lhr-solar/Controls-DashboardPCB/3d models/ToggleSwitch 3Pin.step

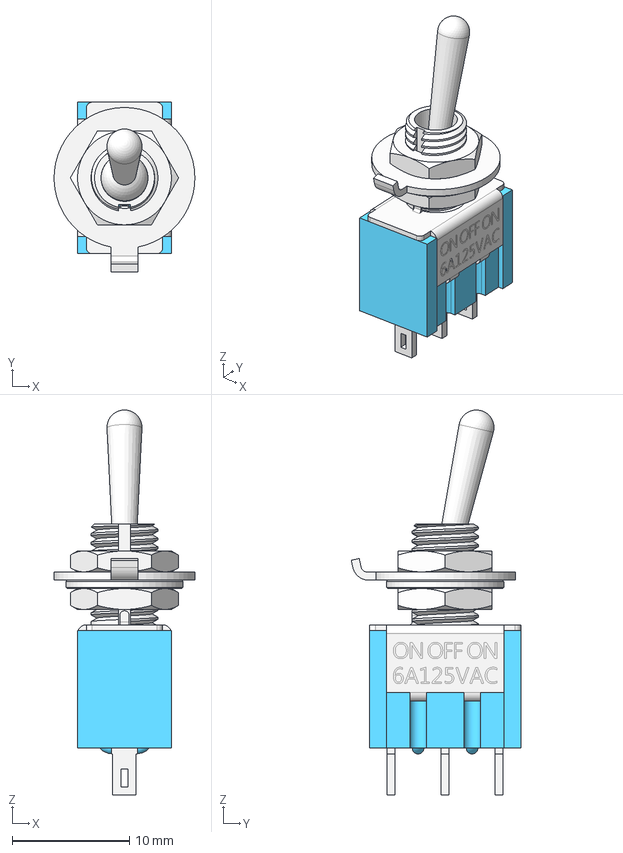
[picture p1: CAD file, 2025-03-05]
3d models/ToggleSwitch 3Pin.step
12.0 x 14.4 x 32.8 mm
Washer Anti Twist Protection
Nut M6x0.75mm
Nut M6x0.75mm clone
Sheetmatal Frame
Plastic Body
Thread
Batton Clone 1
PIN_1of3
PIN_2of3
PIN_3of3
Washer
