lhr-solar/Controls-DashboardPCB/hardware/ControlsLeader_PCB/Footprints/PRESENT Adj LDO/AP2205-50W5-7.STEP

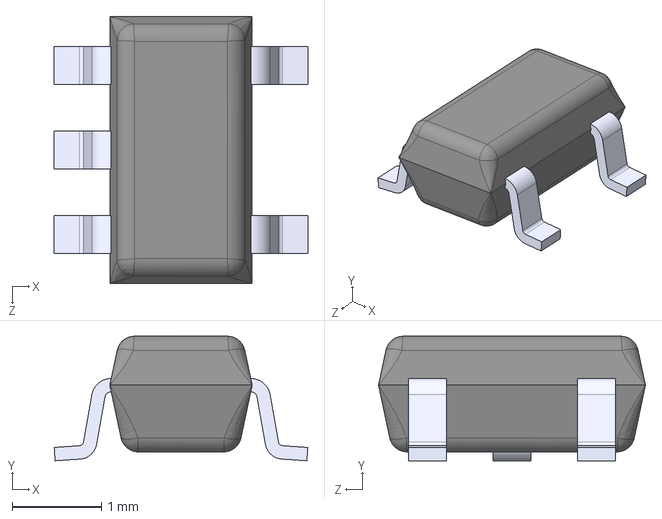
[picture p2: CAD file, 2026-01-14]
hardware/ControlsLeader_PCB/Footprints/PRESENT Adj LDO/AP2205-50W5-7.STEP
2.85 x 1.40 x 3.00 mm
