lhr-solar/Controls-DashboardPCB/3d models/2pin.stp

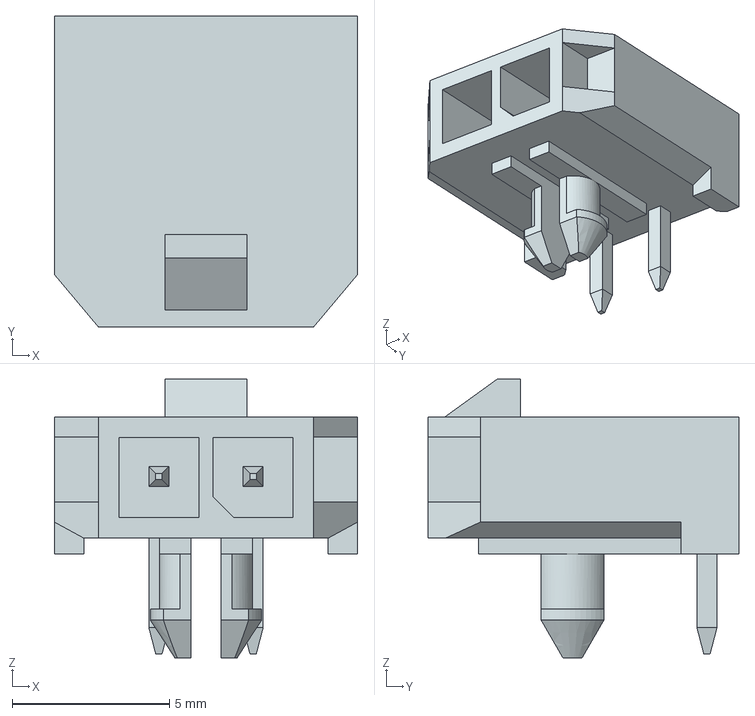
[picture p3: CAD file, 2025-03-05]
3d models/2pin.stp
9.65 x 9.90 x 8.87 mm
