lhr-solar/Controls-DashboardPCB/hardware/ControlsLeader_PCB/3d model/1x3_horizontal.stp

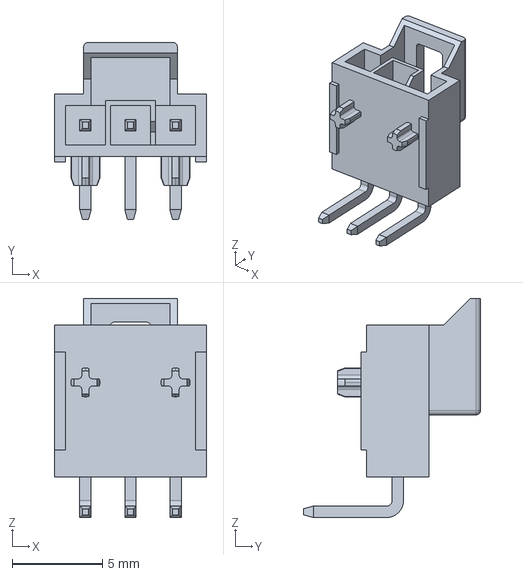
[picture p4: CAD file, 2026-01-15]
hardware/ControlsLeader_PCB/3d model/1x3_horizontal.stp
8.44 x 9.84 x 12.2 mm
