lhr-solar/Controls-DashboardPCB/3d models/2x2.stp

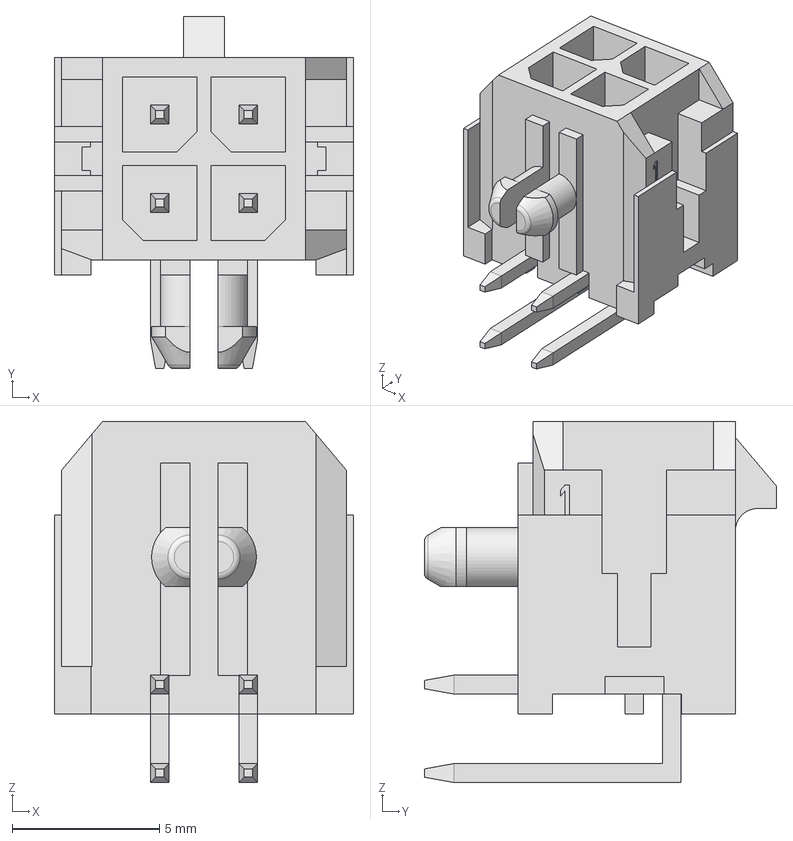
[picture p5: CAD file, 2025-03-05]
3d models/2x2.stp
10.2 x 11.9 x 12.2 mm
