lhr-solar/Controls-DashboardPCB/3d models/ToggleButt.stp

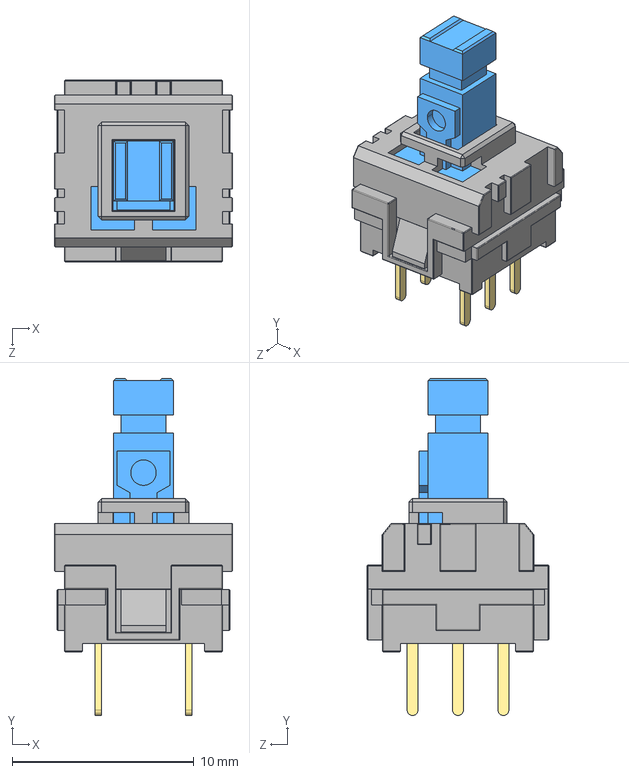
[picture p6: CAD file, 2025-03-05]
3d models/ToggleButt.stp
9.80 x 18.5 x 10.0 mm
