lhr-solar/Controls-DashboardPCB/hardware/ControlsLeader_PCB/3d model/1x06_horizontal.stp

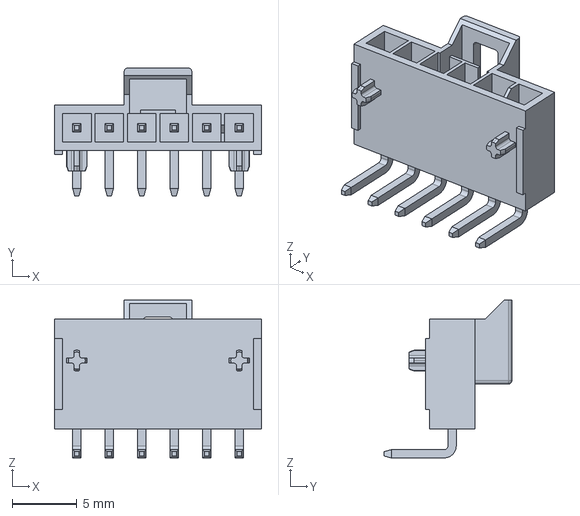
[picture p7: CAD file, 2026-01-15]
hardware/ControlsLeader_PCB/3d model/1x06_horizontal.stp
15.9 x 9.84 x 12.2 mm
