lhr-solar/Controls-DashboardPCB/3d models/rotary.stp

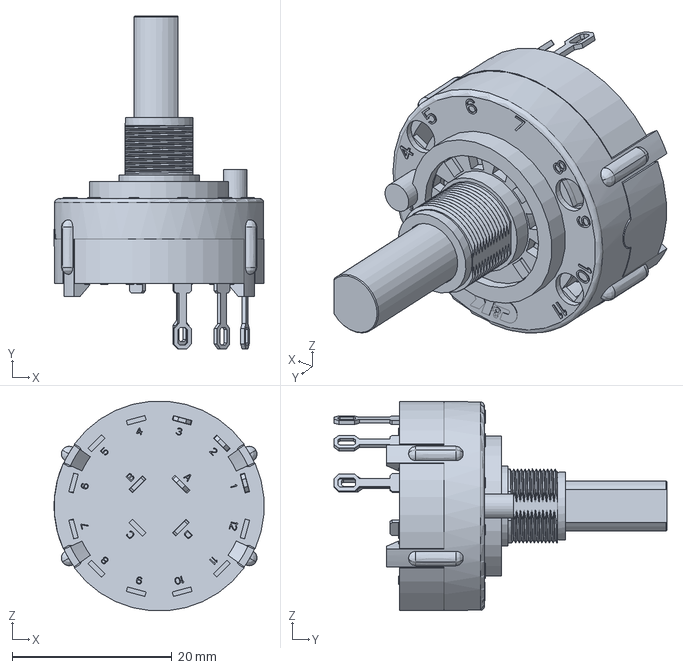
[picture p8: CAD file, 2025-03-05]
3d models/rotary.stp
26.3 x 41.7 x 26.2 mm
