lhr-solar/Controls-DashboardPCB/hardware/ControlsLeader_PCB/3d model/IRLML2030TRPBF.stp

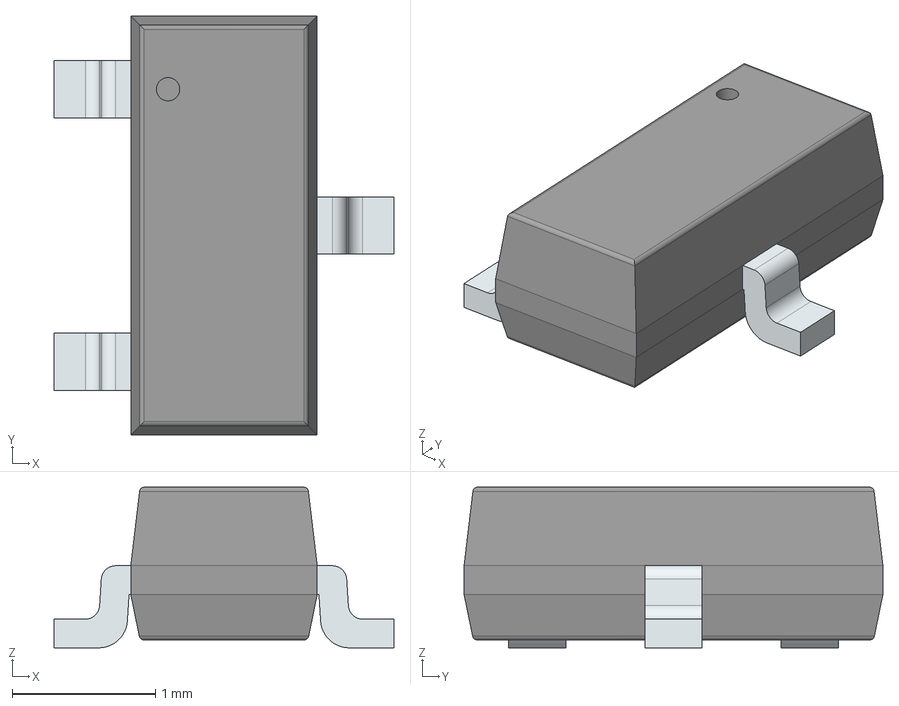
[picture p9: CAD file, 2026-01-15]
hardware/ControlsLeader_PCB/3d model/IRLML2030TRPBF.stp
2.37 x 2.92 x 1.12 mm
PinsArrayL
FilletPinR
