lhr-solar/Controls-DashboardPCB/3d models/Supplemental Battery Switch.STEP

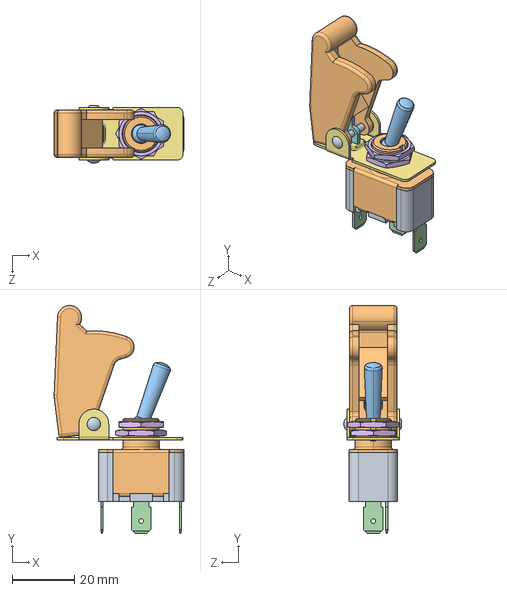
[picture p10: CAD file, 2025-03-05]
3d models/Supplemental Battery Switch.STEP
41.7 x 73.3 x 18.5 mm
22-ENC-1104.1 Supplemental Battery Toggle Switch
22-ENC-1104.2 Supplemental Battery Switch Safety Guard
