lhr-solar/Controls-DashboardPCB/hardware/ControlsLeader_PCB/3d model/2x6_horizontal.stp

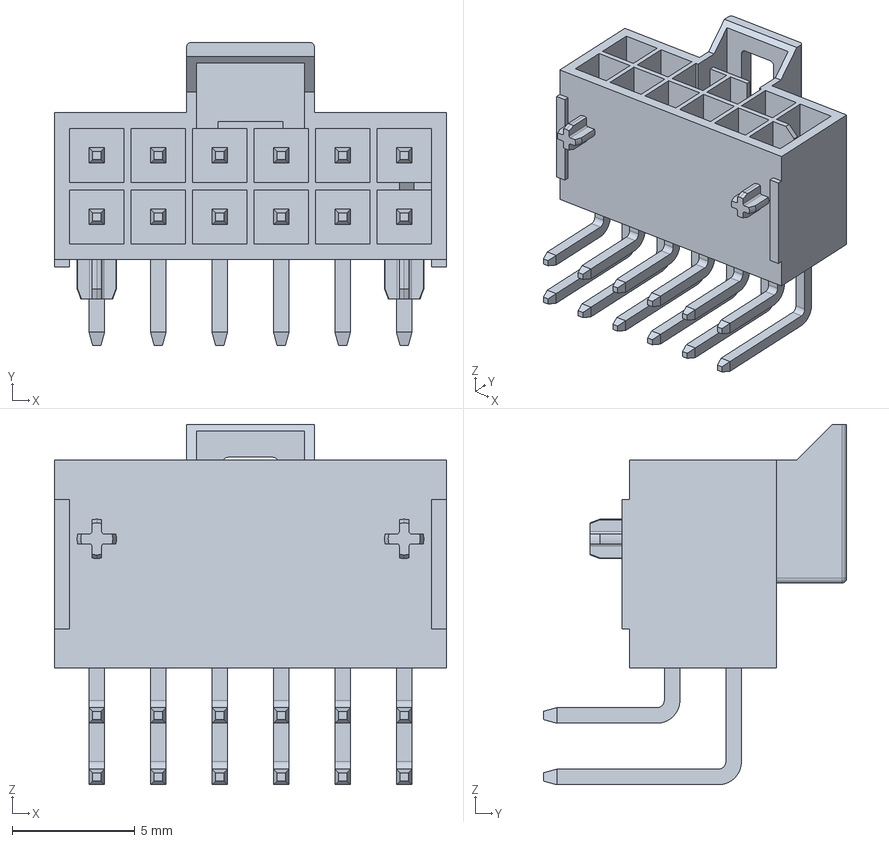
[picture p11: CAD file, 2026-01-15]
hardware/ControlsLeader_PCB/3d model/2x6_horizontal.stp
15.9 x 12.3 x 14.7 mm
