lhr-solar/Controls-DashboardPCB/3d models/2x6.stp

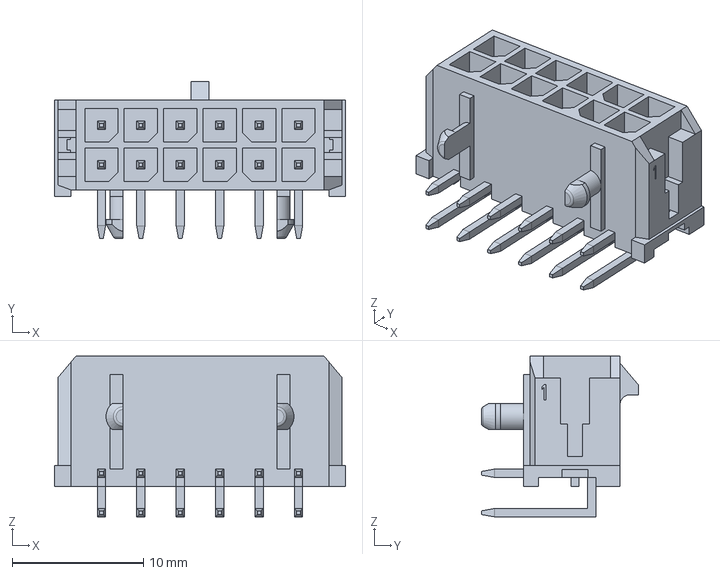
[picture p12: CAD file, 2025-03-05]
3d models/2x6.stp
22.1 x 11.9 x 12.2 mm
