lhr-solar/Controls-DashboardPCB/3d models/1x3.stp

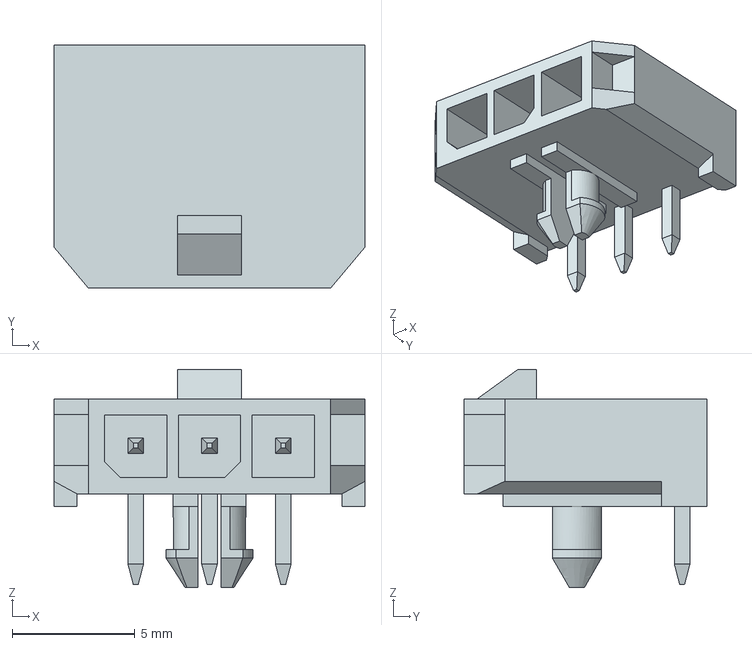
[picture p13: CAD file, 2025-03-05]
3d models/1x3.stp
12.7 x 9.90 x 8.87 mm
