lhr-solar/Controls-DashboardPCB/3d models/2x3.stp

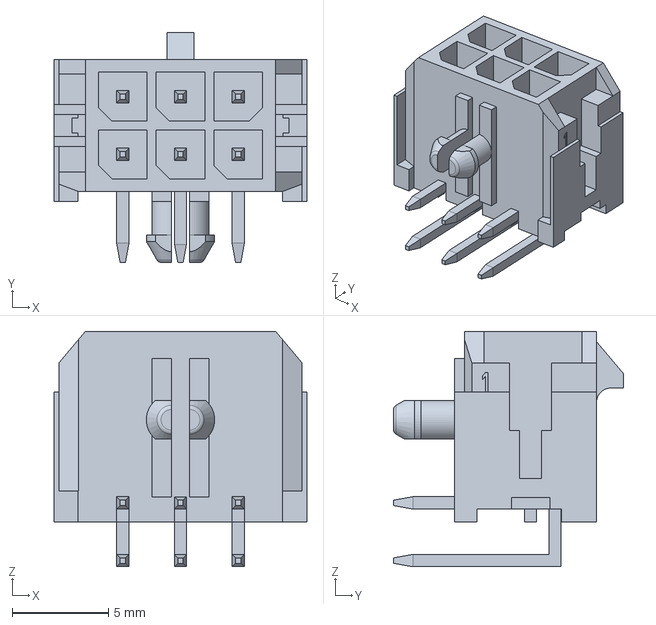
[picture p14: CAD file, 2025-03-05]
3d models/2x3.stp
13.2 x 11.9 x 12.2 mm
