lhr-solar/Controls-DashboardPCB/3d models/slide.STEP

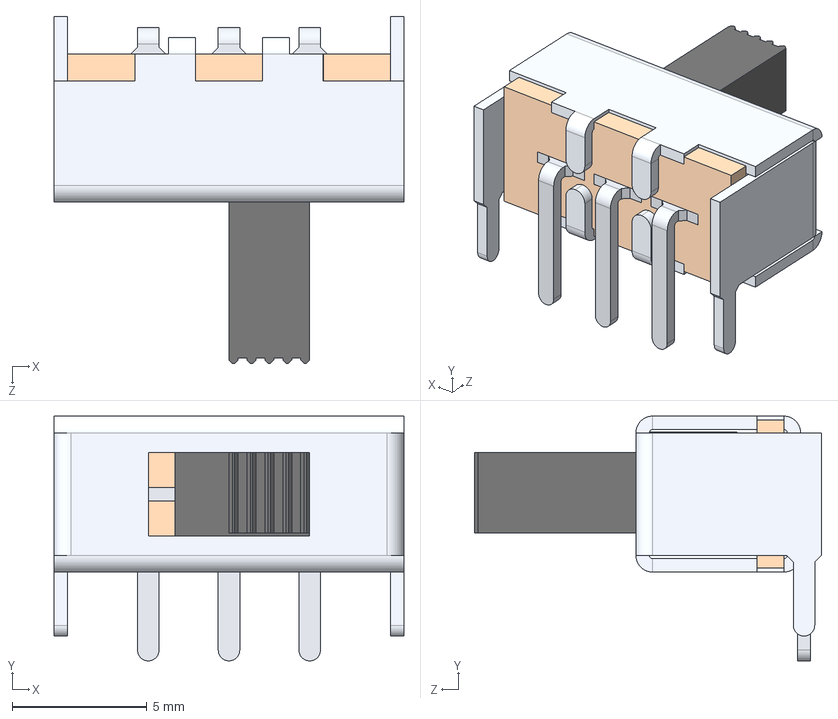
[picture p15: CAD file, 2025-03-05]
3d models/slide.STEP
13.0 x 9.10 x 12.9 mm
SLIDE SWITCH SS12F23 CAPA_Valor predeterminado
SLIDE SWITCH SS12F23 PCB_Valor predeterminado
SLIDE SWITCH SS12F23 CENTRAL_Valor predeterminado
SLIDE SWITCH SS12F23 LATERAL_Valor predeterminado x 2
SLIDE SWITCH SS12F23 ATUADOR_Valor predeterminado
SLIDE SWITCH SS12F23 Contato_Valor predeterminado
