lhr-solar/Controls-DashboardPCB/3d models/1x2vert.stp

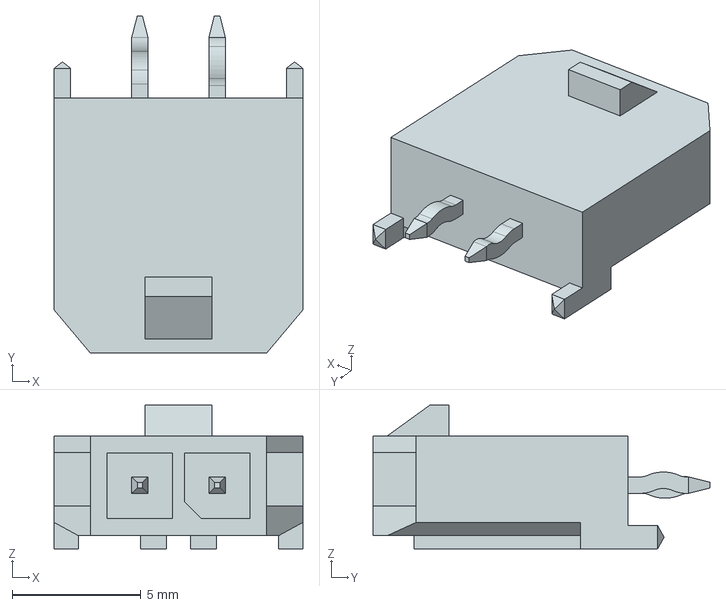
[picture p16: CAD file, 2025-03-05]
3d models/1x2vert.stp
9.65 x 13.1 x 5.57 mm
