lhr-solar/Controls-DashboardPCB/hardware/ControlsLeader_PCB/3d model/0805L100WR.stp

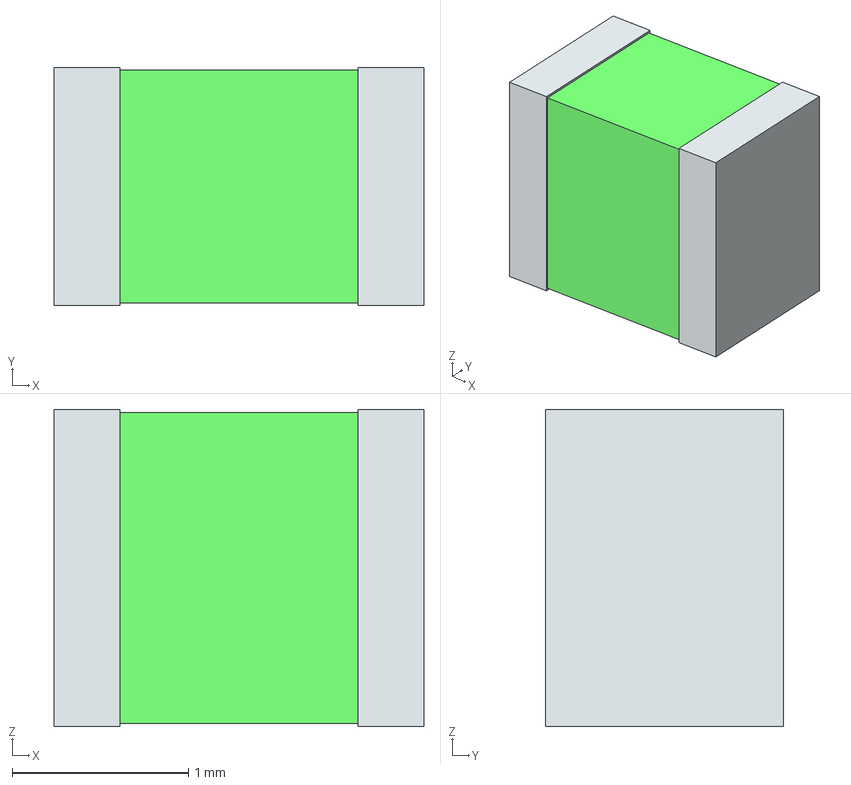
[picture p17: CAD file, 2026-01-15]
hardware/ControlsLeader_PCB/3d model/0805L100WR.stp
2.10 x 1.35 x 1.80 mm
term1
term2
