lhr-solar/Controls-DashboardPCB/(list of files, cad)

Other CAD files:
hardware/ControlsLeader_PCB/3d model/0603L025YR.stp
