lhr-solar/Controls-DashboardPCB/hardware/ControlsLeader_PCB/ControlsLeader_PCB.kicad_pcb

## KiCad design hardware/ControlsLeader_PCB/ControlsLeader_PCB.kicad_pcb (2026-01-15)

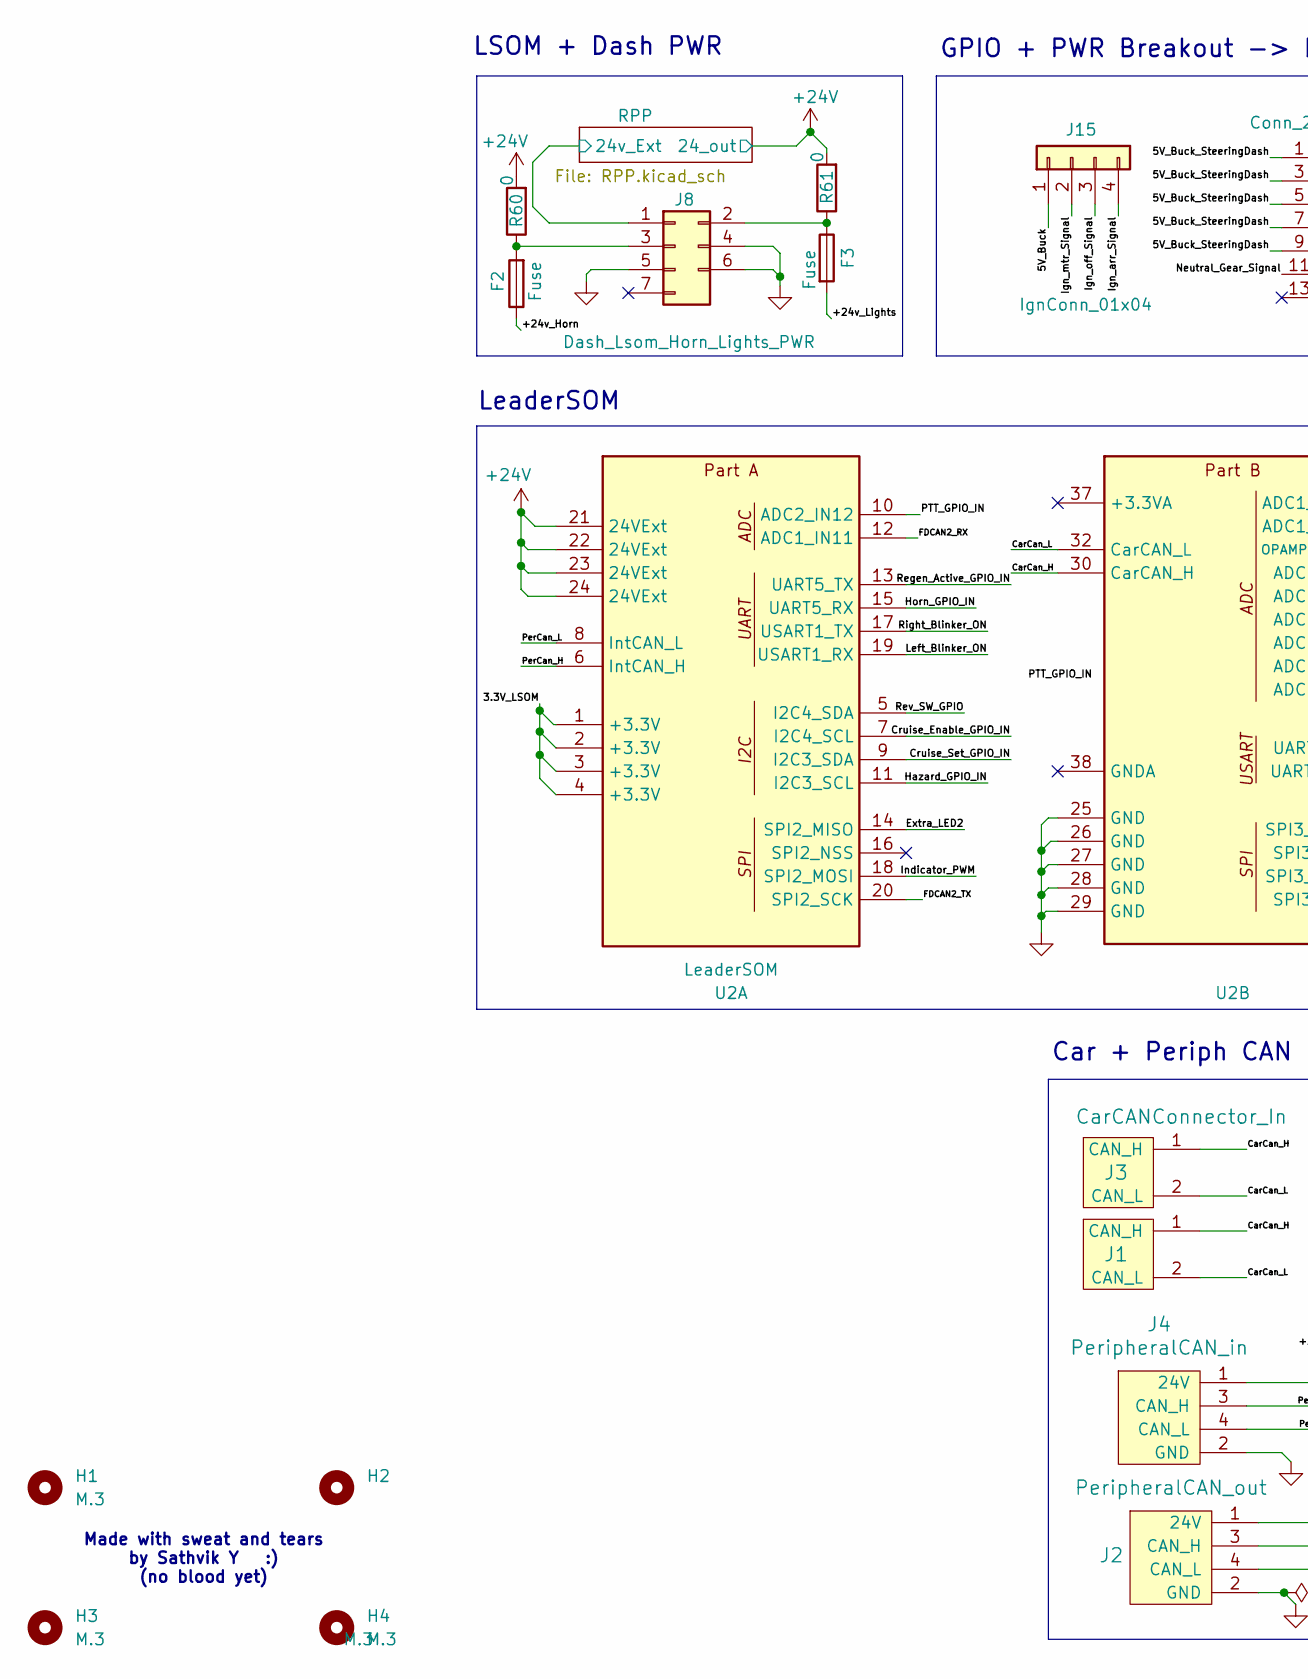
[picture p18: schematic ControlsLeader_PCB.kicad_sch, part in row 1, column 1]

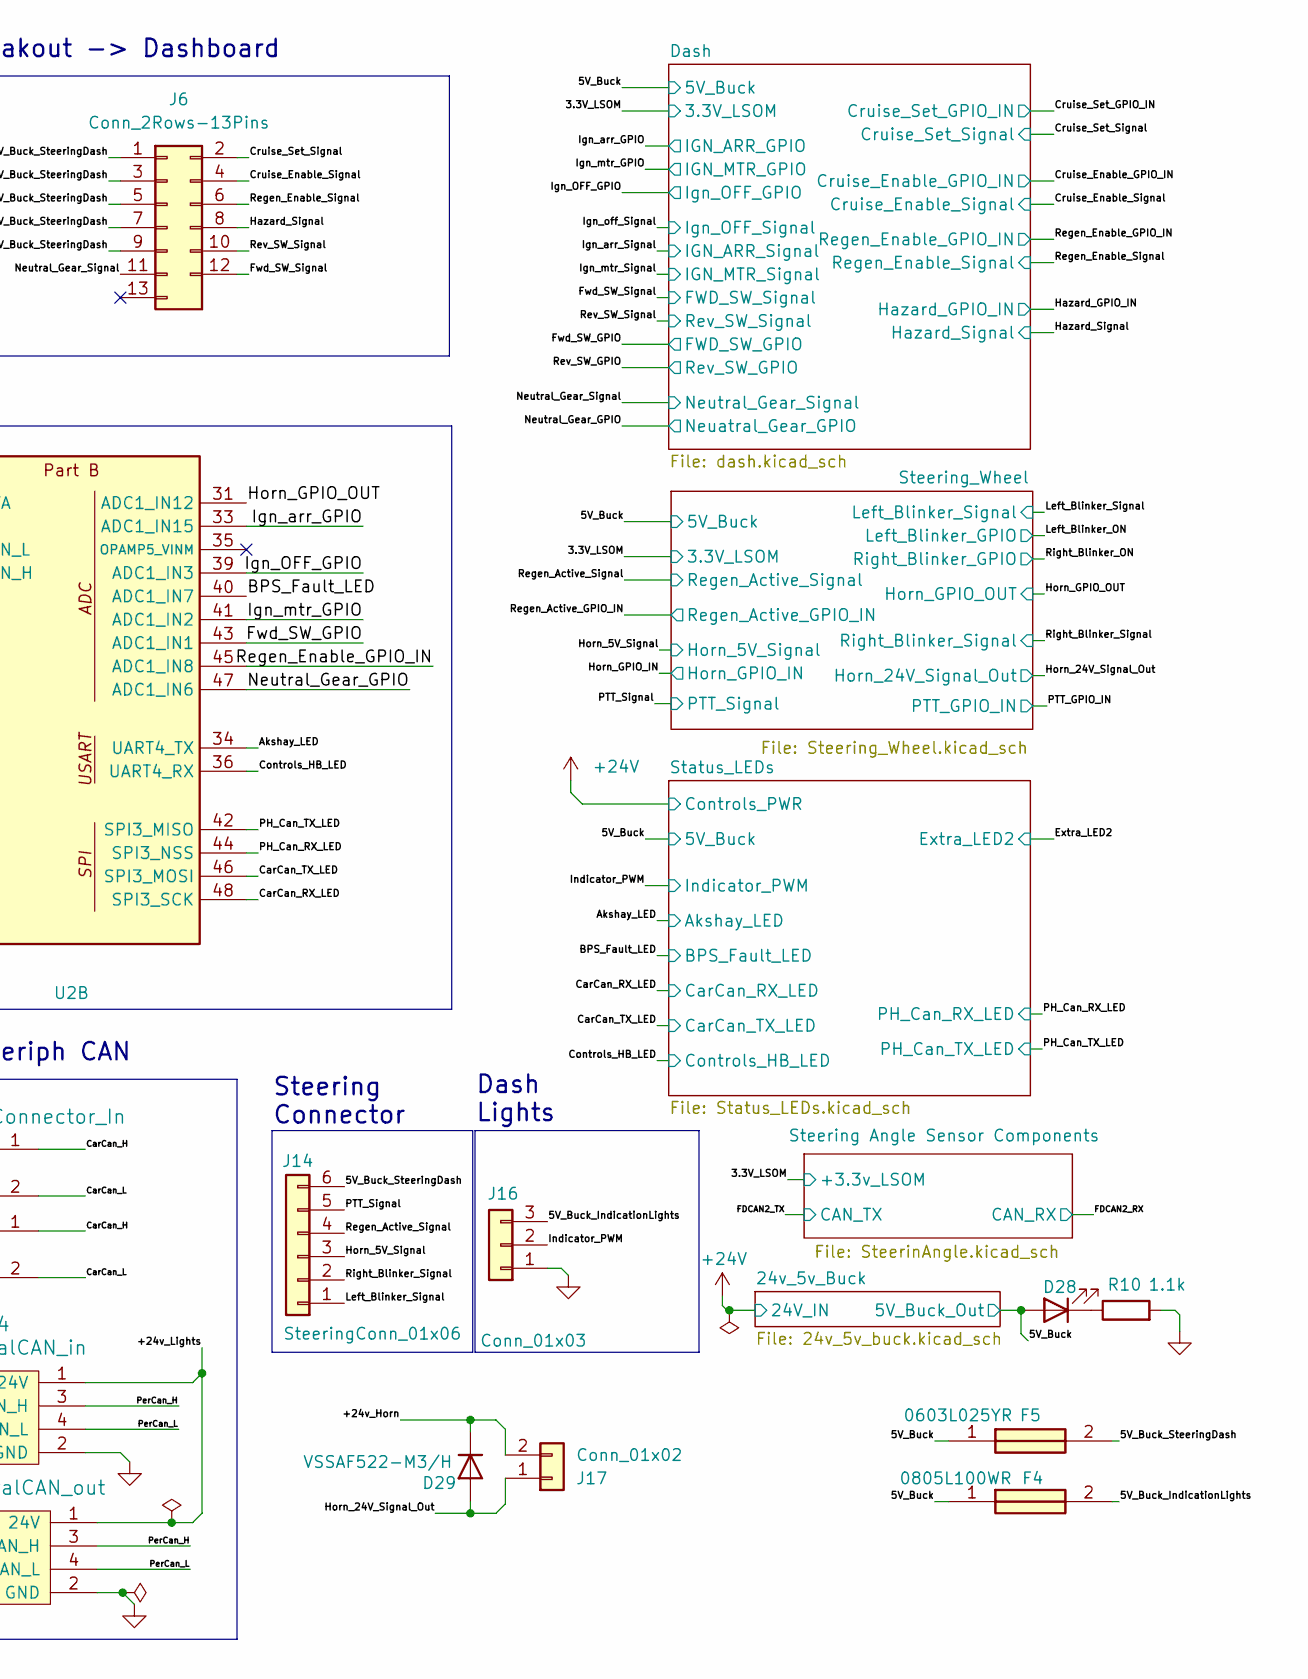
[picture p19: schematic ControlsLeader_PCB.kicad_sch, part in row 1, column 2]

Parts:
D28: Controls_Leader_Status_Red; LED_0603_1608Metric_Pad1.05x0.95mm_HandSolder
D29: VSSAF522-M3/H; D_SOD-123F
F2, F3: Fuse; Fuseholder_Blade_Mini_Keystone_3568
F4: 0805L100WR; FUSC2114X180N; Mouser Part Number 576-0805L100
F5: 0603L025YR; FUSC1608X75N; Mouser Part Number 576-0603L025YR
H1, H2, H3, H4: M.3; MountingHole_3.2mm_M3_Pad_TopBottom
J1: CarCANConnector_Out; Molex_Nano-Fit_105313-xx02_1x02_P2.50mm_Horizontal
J2: PeripheralCAN_out; Molex_Nano-Fit_105313-xx04_1x04_P2.50mm_Horizontal
J3: CarCANConnector_In; Molex_Nano-Fit_105313-xx02_1x02_P2.50mm_Horizontal
J4: PeripheralCAN_in; Molex_Nano-Fit_105313-xx04_1x04_P2.50mm_Horizontal
J6: Conn_2Rows-13Pins; Molex_Nano-Fit_105314-xx12_2x06_P2.50mm_Horizontal
J8: Dash_Lsom_Horn_Lights_PWR; Molex_Nano-Fit_105314-xx06_2x03_P2.50mm_Horizontal
J14: SteeringConn_01x06; Molex_Nano-Fit_105313-xx06_1x06_P2.50mm_Horizontal
J15: IgnConn_01x04; Molex_Nano-Fit_105313-xx04_1x04_P2.50mm_Horizontal
J16: Conn_01x03; Molex_Nano-Fit_105313-xx03_1x03_P2.50mm_Horizontal
J17: Conn_01x02; Molex_Nano-Fit_105313-xx02_1x02_P2.50mm_Horizontal
R10: 1.1k; R_0603_1608Metric_Pad0.98x0.95mm_HandSolder
R60, R61: 0; R_0603_1608Metric_Pad0.98x0.95mm_HandSolder
U2: LeaderSOM

Connections:
+24V: R60.2, R61.2, U2.21 (24VExt), U2.22 (24VExt), U2.23 (24VExt), U2.24 (24VExt); also elsewhere on the board
/3.3V_LSOM: U2.1 (+3.3V), U2.2 (+3.3V), U2.3 (+3.3V), U2.4 (+3.3V); also elsewhere on the board
/5V_Buck: D28.2 (A), F4.1, F5.1, J15.1; also elsewhere on the board
/5V_Buck_IndicationLights: F4.2, J16.3
/5V_Buck_SteeringDash: F5.2, J6.1, J6.3, J6.5, J6.7, J6.9, J14.6
/+24v_Horn: D29.1 (K), F2.1, J17.2
/+24v_Lights: F3.2, J2.1 (24V), J4.1 (24V)
/Akshay_LED: U2.34 (UART4_TX); also elsewhere on the board
/BPS_Fault_LED: U2.40 (ADC1_IN7); also elsewhere on the board
/CarCan_H: J1.1 (CAN_H), J3.1 (CAN_H), U2.30 (CarCAN_H)
/CarCan_L: J1.2 (CAN_L), J3.2 (CAN_L), U2.32 (CarCAN_L)
/CarCan_RX_LED: U2.48 (SPI3_SCK); also elsewhere on the board
/CarCan_TX_LED: U2.46 (SPI3_MOSI); also elsewhere on the board
/Controls_HB_LED: U2.36 (UART4_RX); also elsewhere on the board
/Cruise_Enable_GPIO_IN: U2.7 (I2C4_SCL); also elsewhere on the board
/Cruise_Enable_Signal: J6.4; also elsewhere on the board
/Cruise_Set_GPIO_IN: U2.9 (I2C3_SDA); also elsewhere on the board
/Cruise_Set_Signal: J6.2; also elsewhere on the board
/Extra_LED2: U2.14 (SPI2_MISO); also elsewhere on the board
/FDCAN2_RX: U2.12 (ADC1_IN11); also elsewhere on the board
/FDCAN2_TX: U2.20 (SPI2_SCK); also elsewhere on the board
/Fwd_SW_GPIO: U2.43 (ADC1_IN1); also elsewhere on the board
/Fwd_SW_Signal: J6.12; also elsewhere on the board
/Hazard_GPIO_IN: U2.11 (I2C3_SCL); also elsewhere on the board
/Hazard_Signal: J6.8; also elsewhere on the board
/Horn_5V_Signal: J14.3; also elsewhere on the board
/Horn_24V_Signal_Out: D29.2 (A), J17.1; also elsewhere on the board
/Horn_GPIO_IN: U2.15 (UART5_RX); also elsewhere on the board
/Horn_GPIO_OUT: U2.31 (ADC1_IN12); also elsewhere on the board
/Ign_OFF_GPIO: U2.39 (ADC1_IN3); also elsewhere on the board
/Ign_arr_GPIO: U2.33 (ADC1_IN15); also elsewhere on the board
/Ign_arr_Signal: J15.4; also elsewhere on the board
/Ign_mtr_GPIO: U2.41 (ADC1_IN2); also elsewhere on the board
/Ign_mtr_Signal: J15.2; also elsewhere on the board
/Ign_off_Signal: J15.3; also elsewhere on the board
/Indicator_PWM: J16.2, U2.18 (SPI2_MOSI)
/Left_Blinker_ON: U2.19 (USART1_RX); also elsewhere on the board
/Left_Blinker_Signal: J14.1; also elsewhere on the board
/Neutral_Gear_GPIO: U2.47 (ADC1_IN6); also elsewhere on the board
/Neutral_Gear_Signal: J6.11; also elsewhere on the board
/PH_Can_RX_LED: U2.44 (SPI3_NSS); also elsewhere on the board
/PH_Can_TX_LED: U2.42 (SPI3_MISO); also elsewhere on the board
/PTT_GPIO_IN: U2.10 (ADC2_IN12); also elsewhere on the board
/PTT_Signal: J14.5; also elsewhere on the board
/PerCan_H: J2.3 (CAN_H), J4.3 (CAN_H), U2.6 (IntCAN_H)
/PerCan_L: J2.4 (CAN_L), J4.4 (CAN_L), U2.8 (IntCAN_L)
/RPP/LV+: J8.1; also elsewhere on the board
/Regen_Active_GPIO_IN: U2.13 (UART5_TX); also elsewhere on the board
/Regen_Active_Signal: J14.4; also elsewhere on the board
/Regen_Enable_GPIO_IN: U2.45 (ADC1_IN8); also elsewhere on the board
/Regen_Enable_Signal: J6.6; also elsewhere on the board
/Rev_SW_GPIO: U2.5 (I2C4_SDA); also elsewhere on the board
/Rev_SW_Signal: J6.10; also elsewhere on the board
/Right_Blinker_ON: U2.17 (USART1_TX); also elsewhere on the board
/Right_Blinker_Signal: J14.2; also elsewhere on the board
GND: J2.2 (GND), J4.2 (GND), J8.4, J8.5, J8.6, J16.1, R10.2, U2.25 (GND), U2.26 (GND), U2.27 (GND), U2.28 (GND), U2.29 (GND); also elsewhere on the board
unnamed: D28.1 (K), R10.1
unnamed: F3.1, J8.2, R61.1
unnamed: F2.2, J8.3, R60.1

Notes on the sheet:
Car + Periph CAN
Dash Lights
GPIO + PWR Breakout -> Dashboard
Steering Connector
LSOM + Dash PWR
LeaderSOM
Made with sweat and tears by Sathvik Y :) (no blood yet)

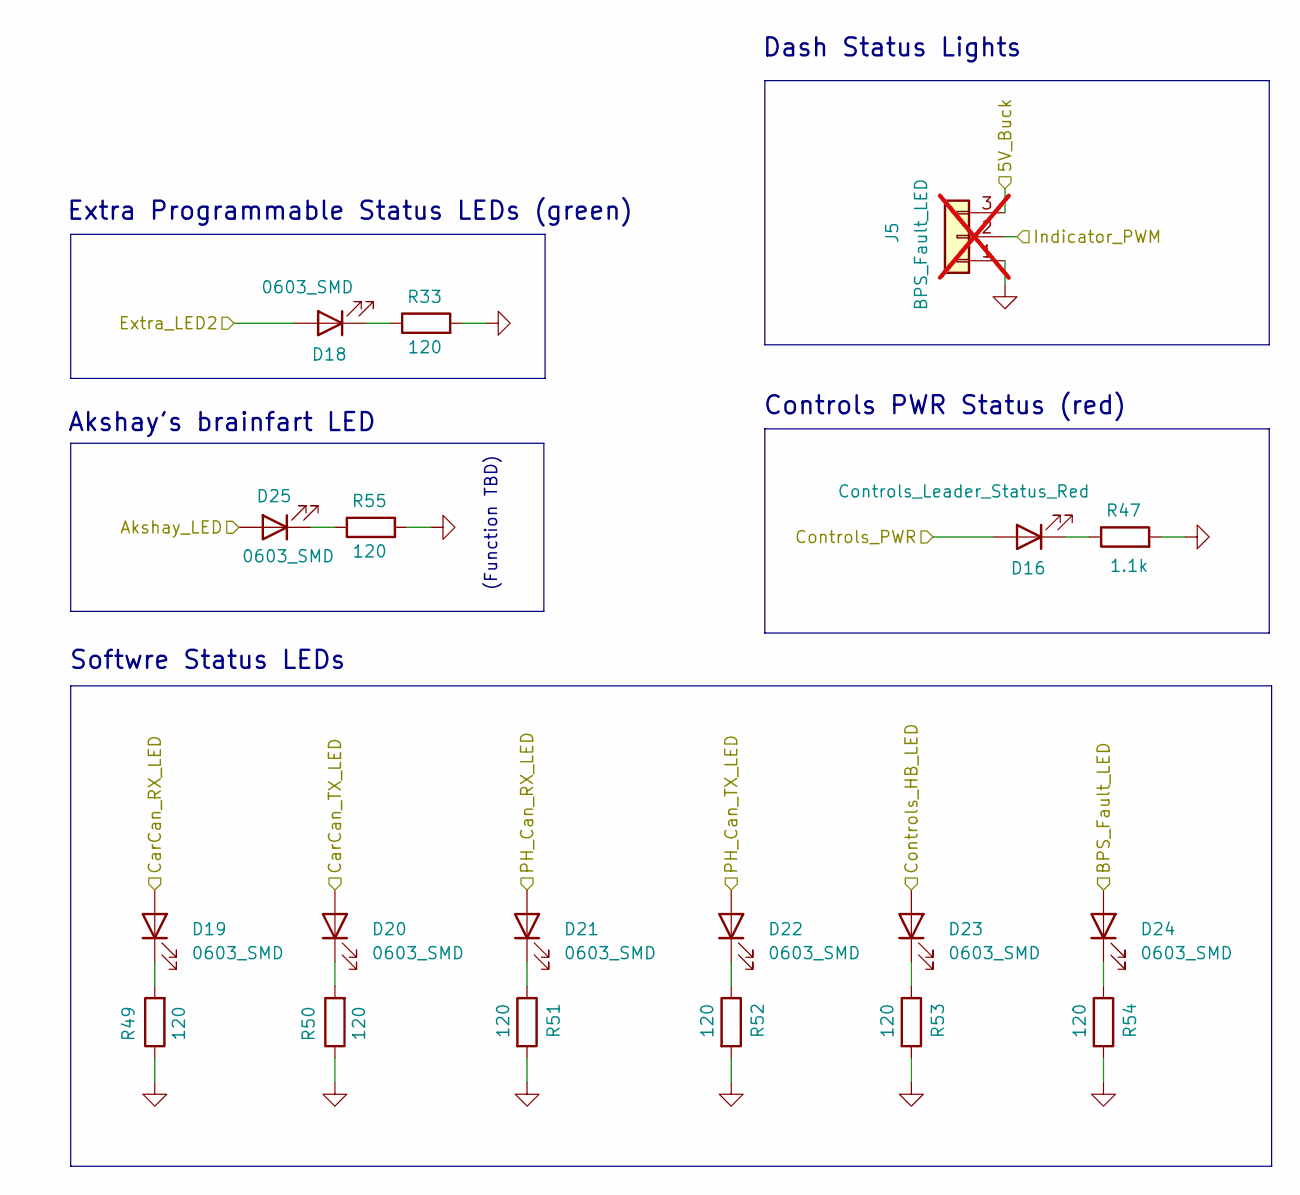
[picture p20: schematic Status_LEDs.kicad_sch]

Parts:
D16: Controls_Leader_Status_Red; LED_0603_1608Metric_Pad1.05x0.95mm_HandSolder
D18, D19, D20, D21, D22, D23, D24, D25: 0603_SMD; LED_0603_1608Metric_Pad1.05x0.95mm_HandSolder
J5: BPS_Fault_LED; Molex_Micro-Fit_3.0_43650-0300_1x03_P3.00mm_Horizontal; not fitted
R33, R49, R50, R51, R52, R53, R54, R55: 120; R_0603_1608Metric_Pad0.98x0.95mm_HandSolder
R47: 1.1k; R_0603_1608Metric_Pad0.98x0.95mm_HandSolder

Connections:
+24V: D16.2 (A); also elsewhere on the board
/Akshay_LED: D25.2 (A); also elsewhere on the board
/BPS_Fault_LED: D24.2 (A); also elsewhere on the board
/CarCan_RX_LED: D19.2 (A); also elsewhere on the board
/CarCan_TX_LED: D20.2 (A); also elsewhere on the board
/Controls_HB_LED: D23.2 (A); also elsewhere on the board
/Extra_LED2: D18.2 (A); also elsewhere on the board
/PH_Can_RX_LED: D21.2 (A); also elsewhere on the board
/PH_Can_TX_LED: D22.2 (A); also elsewhere on the board
GND: J5.1, R33.2, R47.2, R49.1, R50.1, R51.2, R52.2, R53.2, R54.2, R55.2; also elsewhere on the board
unnamed: D16.1 (K), R47.1
unnamed: D18.1 (K), R33.1
unnamed: D19.1 (K), R49.2
unnamed: D20.1 (K), R50.2
unnamed: D21.1 (K), R51.1
unnamed: D22.1 (K), R52.1
unnamed: D23.1 (K), R53.1
unnamed: D24.1 (K), R54.1
unnamed: D25.1 (K), R55.1

Notes on the sheet:
Akshay's brainfart LED
Extra Programmable Status LEDs (green)
Softwre Status LEDs
Controls PWR Status (red)
(Function TBD)
Dash Status Lights

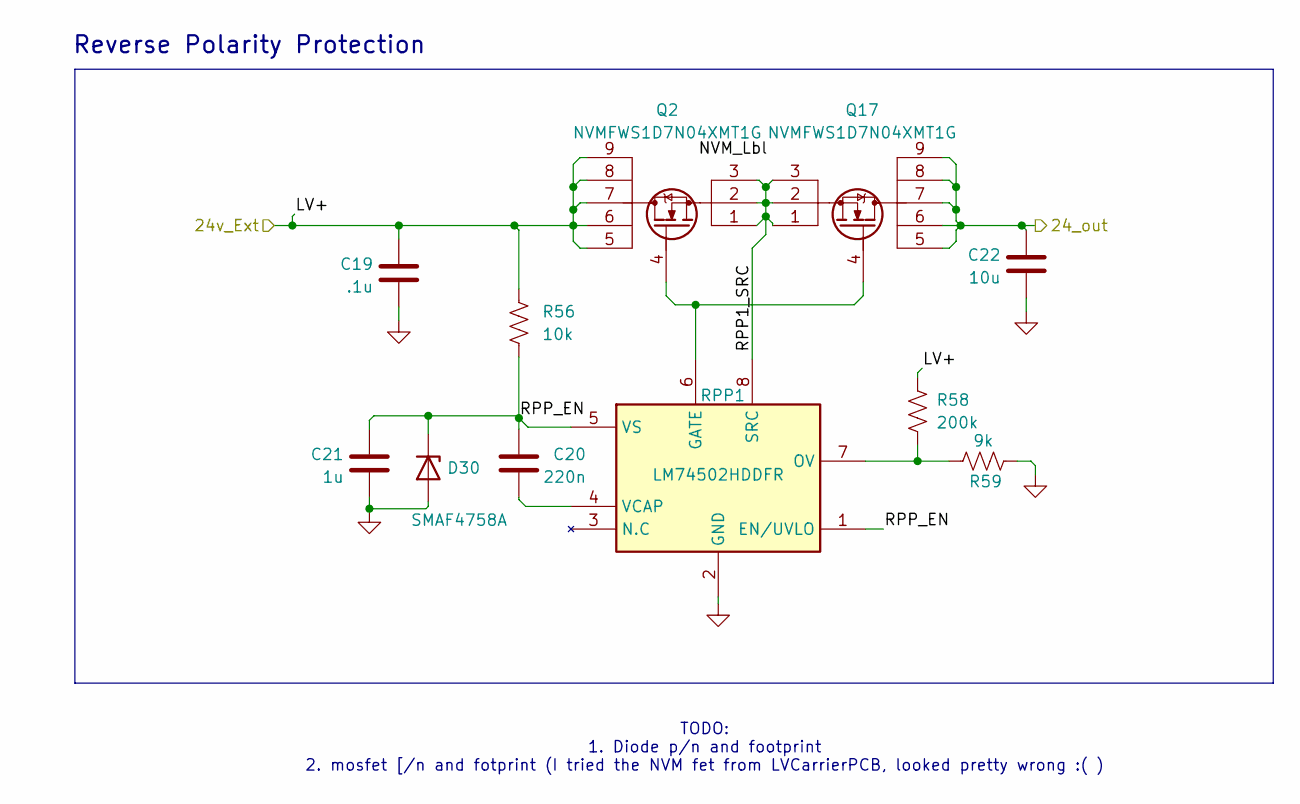
[picture p21: schematic RPP.kicad_sch]

Parts:
C19: .1u; C_0603_1608Metric_Pad1.08x0.95mm_HandSolder; Manufacturer_Part_Number 06035C223K4T4A
C20: 220n; C_0603_1608Metric_Pad1.08x0.95mm_HandSolder; Manufacturer_Part_Number 06035C223K4T4A
C21: 1u; C_0603_1608Metric_Pad1.08x0.95mm_HandSolder; Manufacturer_Part_Number 06035C223K4T4A
C22: 10u; C_0603_1608Metric_Pad1.08x0.95mm_HandSolder; Manufacturer_Part_Number 06035C223K4T4A
D30: SMAF4758A; SODFL5026X125N
Q2, Q17: NVMFWS1D7N04XMT1G; NVMFWS3D0P04M8LT1G
R56: 10k; R_0603_1608Metric_Pad0.98x0.95mm_HandSolder; Manufacturer_Part_Number CRCW060310K0FKEI
R58: 200k; R_0603_1608Metric_Pad0.98x0.95mm_HandSolder; Manufacturer_Part_Number CRCW060310K0FKEI
R59: 9k; R_0603_1608Metric_Pad0.98x0.95mm_HandSolder; Manufacturer_Part_Number CRCW060310K0FKEI
RPP1: LM74502HDDFR; SOT65P280X110-8N; Mouser Part Number 595-LM74502HDDFR

Connections:
+24V: C22.2, Q17.5, Q17.6, Q17.7, Q17.8, Q17.9; also elsewhere on the board
/RPP/LV+: C19.2, Q2.5, Q2.6, Q2.7, Q2.8, Q2.9, R56.1, R58.1; also elsewhere on the board
/RPP/RPP1_SRC: Q2.1, Q2.2, Q2.3, Q17.1, Q17.2, Q17.3, RPP1.8 (SRC)
/RPP/RPP_EN: C20.2, C21.2, D30.1 (K), R56.2, RPP1.1 (EN/UVLO), RPP1.5 (VS)
GND: C19.1, C21.1, C22.1, D30.2 (A), R59.2, RPP1.2 (GND); also elsewhere on the board
unnamed: Q2.4, Q17.4, RPP1.6 (GATE)
unnamed: R58.2, R59.1, RPP1.7 (OV)
unnamed: C20.1, RPP1.4 (VCAP)

Notes on the sheet:
TODO: 1. Diode p/n and footprint 2. mosfet [/n and fotprint (I tried the NVM fet from LVCarrierPCB, looked pretty wrong :( )
Reverse Polarity Protection

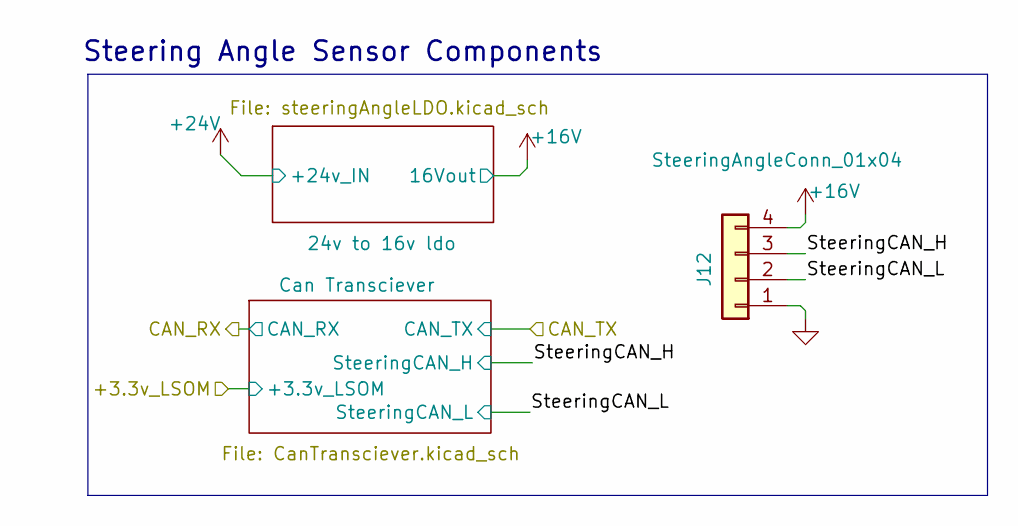
[picture p22: schematic SteerinAngle.kicad_sch]

Parts:
J12: SteeringAngleConn_01x04; Molex_Nano-Fit_105313-xx04_1x04_P2.50mm_Horizontal

Connections:
+16V: J12.4; also elsewhere on the board
/Steering Angle Sensor Components/SteeringCAN_H: J12.3; also elsewhere on the board
/Steering Angle Sensor Components/SteeringCAN_L: J12.2; also elsewhere on the board
GND: J12.1; also elsewhere on the board

Notes on the sheet:
Steering Angle Sensor Components

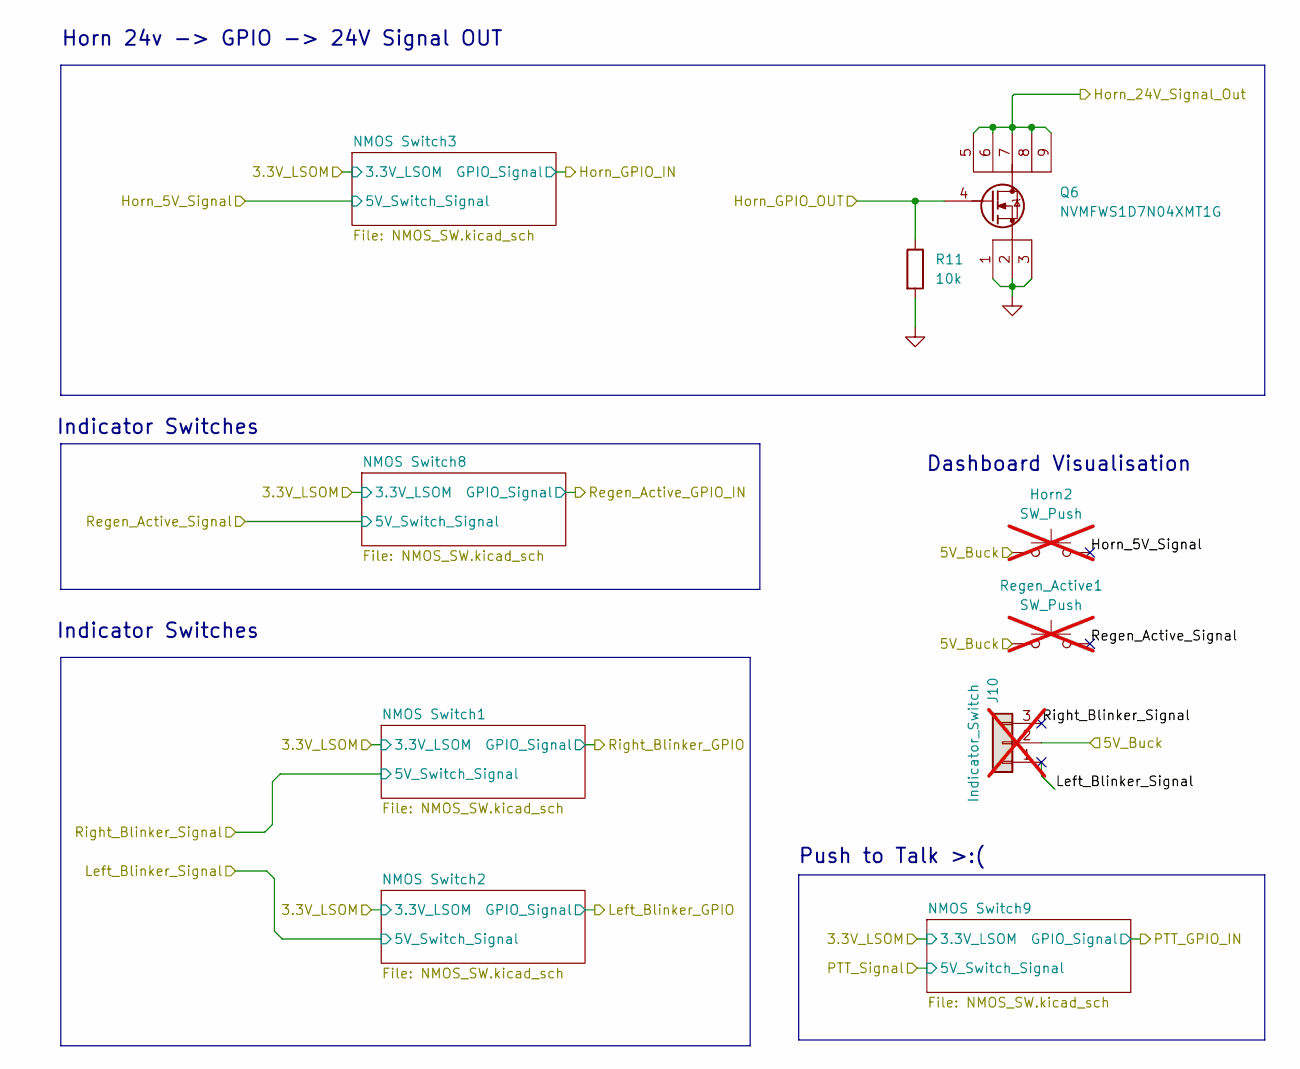
[picture p23: schematic Steering_Wheel.kicad_sch]

Parts:
Horn2: SW_Push; Molex_Nano-Fit_105313-xx02_1x02_P2.50mm_Horizontal; not fitted
J10: Indicator_Switch; Molex_Nano-Fit_105313-xx03_1x03_P2.50mm_Horizontal; not fitted
Q6: NVMFWS1D7N04XMT1G; NVMFWS3D0P04M8LT1G
R11: 10k; R_0603_1608Metric_Pad0.98x0.95mm_HandSolder
Regen_Active1: SW_Push; Molex_Nano-Fit_105313-xx02_1x02_P2.50mm_Horizontal; not fitted

Connections:
/Horn_24V_Signal_Out: Q6.5, Q6.6, Q6.7, Q6.8, Q6.9; also elsewhere on the board
/Horn_GPIO_OUT: Q6.4, R11.1; also elsewhere on the board
GND: Q6.1, Q6.2, Q6.3, R11.2; also elsewhere on the board
unnamed: Horn2.1, J10.2, Regen_Active1.1

Notes on the sheet:
Push to Talk >:(
Indicator Switches
Horn 24v -> GPIO -> 24V Signal OUT
Dashboard Visualisation

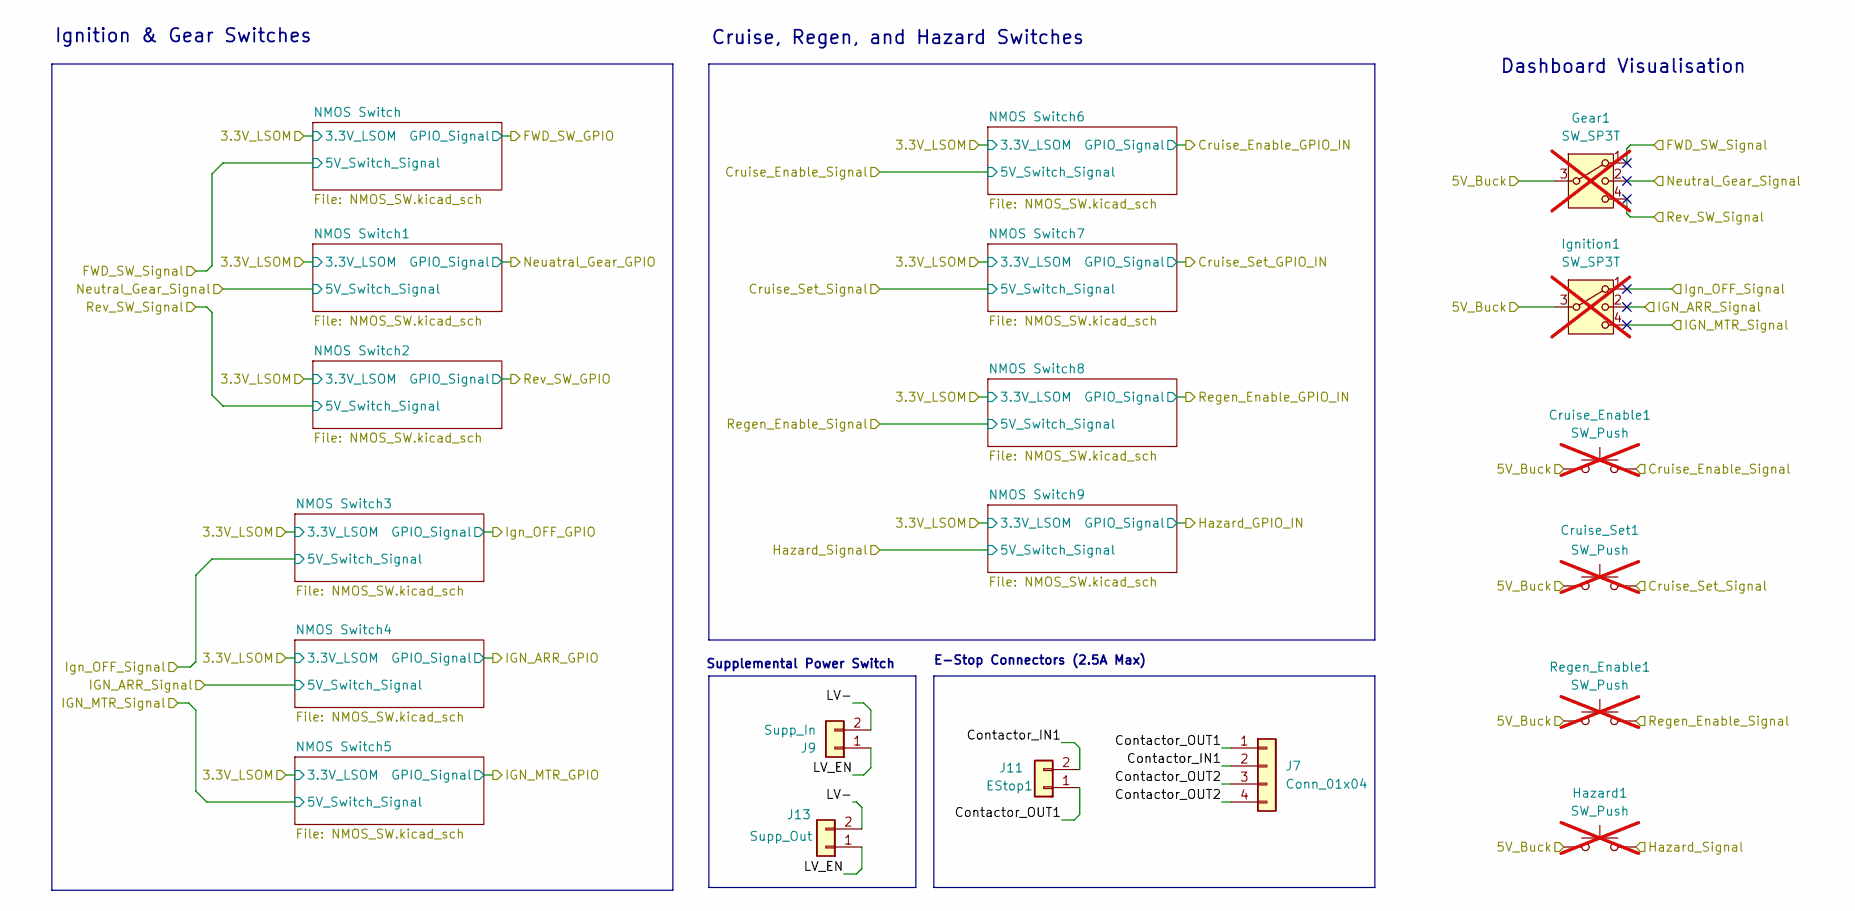
[picture p24: schematic dash.kicad_sch]

Parts:
Cruise_Enable1: SW_Push; Molex_Nano-Fit_105313-xx02_1x02_P2.50mm_Horizontal; not fitted
Cruise_Set1: SW_Push; Molex_Nano-Fit_105313-xx02_1x02_P2.50mm_Horizontal; not fitted
Gear1: SW_SP3T; CONN_SD-105313-100_04_MOL; not fitted
Hazard1: SW_Push; Molex_Nano-Fit_105313-xx02_1x02_P2.50mm_Horizontal; not fitted
Ignition1: SW_SP3T; CONN_SD-105313-100_04_MOL; not fitted
J7: Conn_01x04; Molex_Nano-Fit_105313-xx04_1x04_P2.50mm_Horizontal
J9: Supp_In; Molex_Nano-Fit_105313-xx02_1x02_P2.50mm_Horizontal
J11: EStop1; Molex_Nano-Fit_105313-xx02_1x02_P2.50mm_Horizontal
J13: Supp_Out; Molex_Nano-Fit_105313-xx02_1x02_P2.50mm_Horizontal
Regen_Enable1: SW_Push; Molex_Nano-Fit_105313-xx02_1x02_P2.50mm_Horizontal; not fitted

Connections:
/Dash/Contactor_IN1: J7.2, J11.2
/Dash/Contactor_OUT1: J7.1, J11.1
/Dash/Contactor_OUT2: J7.3, J7.4
/Dash/LV-: J9.2, J13.2
/Dash/LV_EN: J9.1, J13.1
unnamed: Cruise_Enable1.1, Cruise_Set1.1, Gear1.3, Hazard1.1, Ignition1.3, Regen_Enable1.1

Notes on the sheet:
E-Stop Connectors (2.5A Max)
Dashboard Visualisation
Cruise, Regen, and Hazard Switches
Ignition & Gear Switches
Supplemental Power Switch

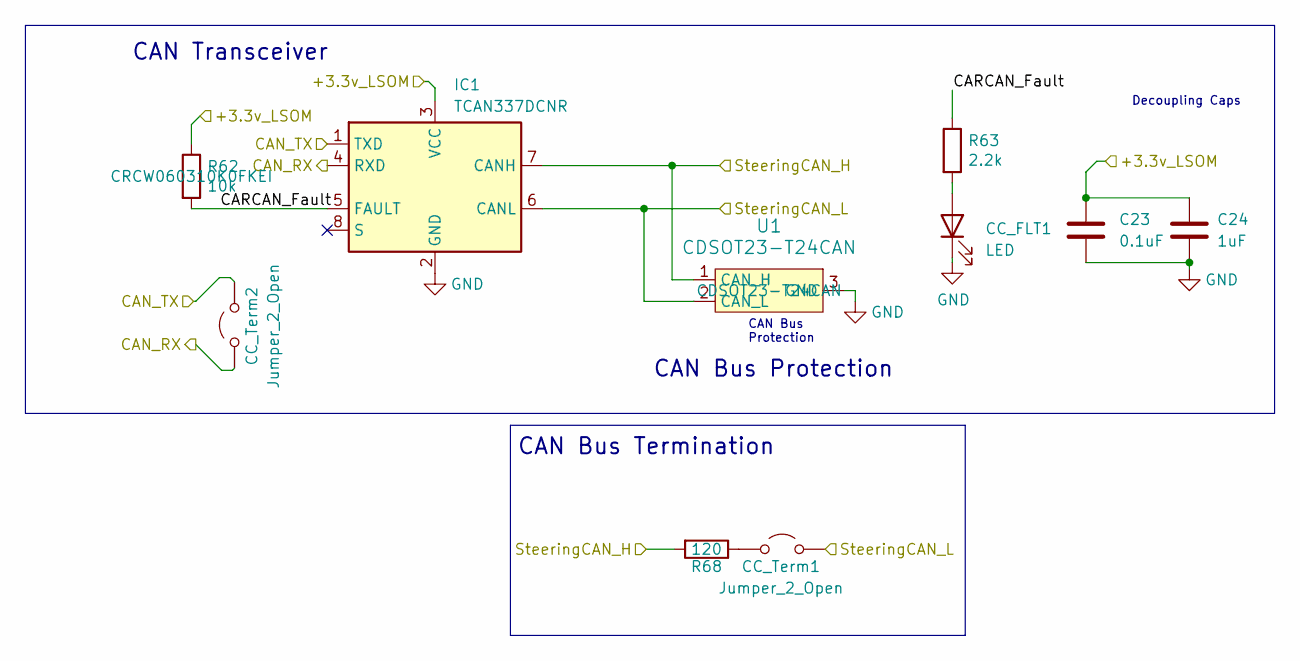
[picture p25: schematic CanTransciever.kicad_sch]

Parts:
C23: 0.1uF; C_0603_1608Metric_Pad1.08x0.95mm_HandSolder; Mouser Part Number MLASH168SB7104KTNA01
C24: 1uF; C_0603_1608Metric_Pad1.08x0.95mm_HandSolder; Mouser Part Number MLASU168SB5105KTNA01
CC_FLT1: LED; LED_0603_1608Metric_Pad1.05x0.95mm_HandSolder; Mouser Part Number 604-APTD2012LCGCK
CC_Term1, CC_Term2: Jumper_2_Open; PinHeader_1x02_P2.54mm_Vertical
IC1: TCAN337DCNR; Mouser Part Number 595-TCAN337DCNR
R62: 10k; R_0603_1608Metric_Pad0.98x0.95mm_HandSolder; Mouser Part Number CRCW060310K0FKEI
R63: 2.2k; R_0603_1608Metric_Pad0.98x0.95mm_HandSolder; Mouser Part Number CRCW06032K10FKEA
R68: 120; R_0603_1608Metric_Pad0.98x0.95mm_HandSolder; Mouser Part Number CRCW0603120RFKEC
U1: CDSOT23-T24CAN; Mouser Part Number CDSOT23-T24CAN

Connections:
/3.3V_LSOM: C23.1, C24.1, IC1.3 (VCC), R62.1; also elsewhere on the board
/FDCAN2_RX: CC_Term2.1 (A), IC1.4 (RXD); also elsewhere on the board
/FDCAN2_TX: CC_Term2.2 (B), IC1.1 (TXD); also elsewhere on the board
/Steering Angle Sensor Components/Can Transciever/CARCAN_Fault: IC1.5 (FAULT), R62.2, R63.1
/Steering Angle Sensor Components/SteeringCAN_H: IC1.7 (CANH), R68.2, U1.1 (CAN_H); also elsewhere on the board
/Steering Angle Sensor Components/SteeringCAN_L: CC_Term1.2 (B), IC1.6 (CANL), U1.2 (CAN_L); also elsewhere on the board
GND: C23.2, C24.2, CC_FLT1.1 (K), IC1.2 (GND), U1.3 (GND); also elsewhere on the board
unnamed: CC_FLT1.2 (A), R63.2
unnamed: CC_Term1.1 (A), R68.1

Notes on the sheet:
CAN Bus Protection
Decoupling Caps
CAN Bus Protection
CAN Transceiver
CAN Bus Termination

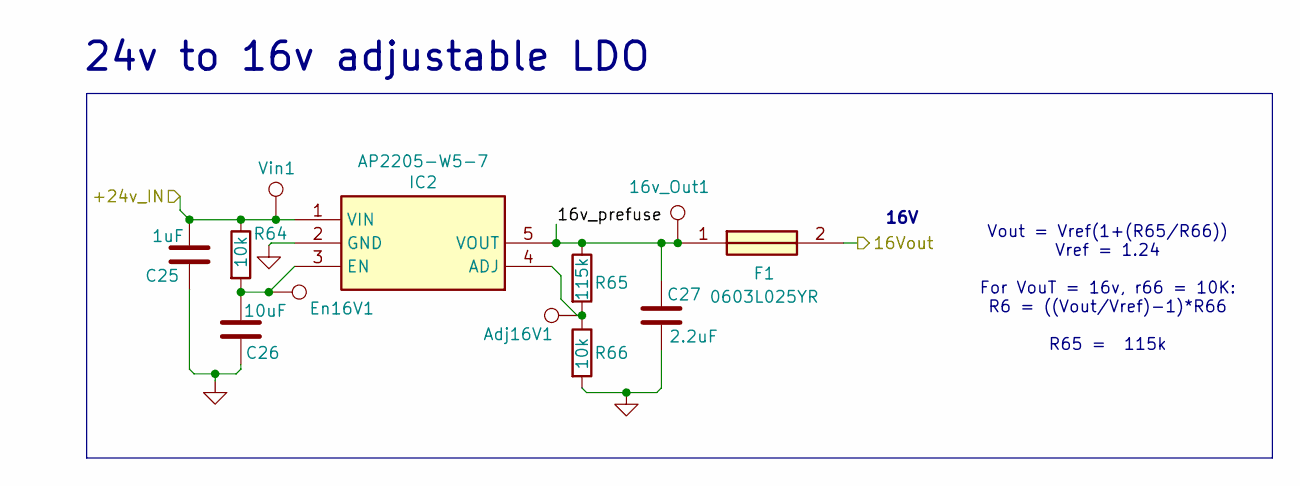
[picture p26: schematic steeringAngleLDO.kicad_sch]

Parts:
16v_Out1: 5V_Out; TestPoint_Pad_1.0x1.0mm
Adj16V1: Adj5V; TestPoint_Pad_1.0x1.0mm
C25: 1uF; C_0603_1608Metric_Pad1.08x0.95mm_HandSolder
C26: 10uF; C_0603_1608Metric_Pad1.08x0.95mm_HandSolder
C27: 2.2uF; C_0603_1608Metric_Pad1.08x0.95mm_HandSolder
En16V1: Enable5V; TestPoint_Pad_1.0x1.0mm
F1: 0603L025YR; FUSC1608X75N; Mouser Part Number 576-0603L025YR
IC2: AP2205-W5-7; AP2205W57; Mouser Part Number 621-AP2205-W5-7
R64, R66: 10k; R_0603_1608Metric_Pad0.98x0.95mm_HandSolder
R65: 115k; R_0603_1608Metric_Pad0.98x0.95mm_HandSolder
Vin1: Vin; TestPoint_Pad_1.0x1.0mm

Connections:
+16V: F1.2; also elsewhere on the board
+24V: C25.2, IC2.1 (VIN), R64.1, Vin1.1; also elsewhere on the board
/Steering Angle Sensor Components/24v to 16v ldo/16v_prefuse: 16v_Out1.1, C27.1, F1.1, IC2.5 (VOUT), R65.1
GND: C25.1, C26.1, C27.2, IC2.2 (GND), R66.2; also elsewhere on the board
unnamed: Adj16V1.1, IC2.4 (ADJ), R65.2, R66.1
unnamed: C26.2, En16V1.1, IC2.3 (EN), R64.2

Notes on the sheet:
Vout = Vref(1+(R65/R66)) Vref = 1.24 For VouT = 16v, r66 = 10K: R6 = ((Vout/Vref)-1)*R66 R65 = 115k
24v to 16v adjustable LDO
16V
