lhr-solar/Controls-DashboardPCB/hardware/ControlsLeader_PCB/ControlsLeader_PCB.kicad_pcb

## KiCad design hardware/ControlsLeader_PCB/ControlsLeader_PCB.kicad_pcb (continued)

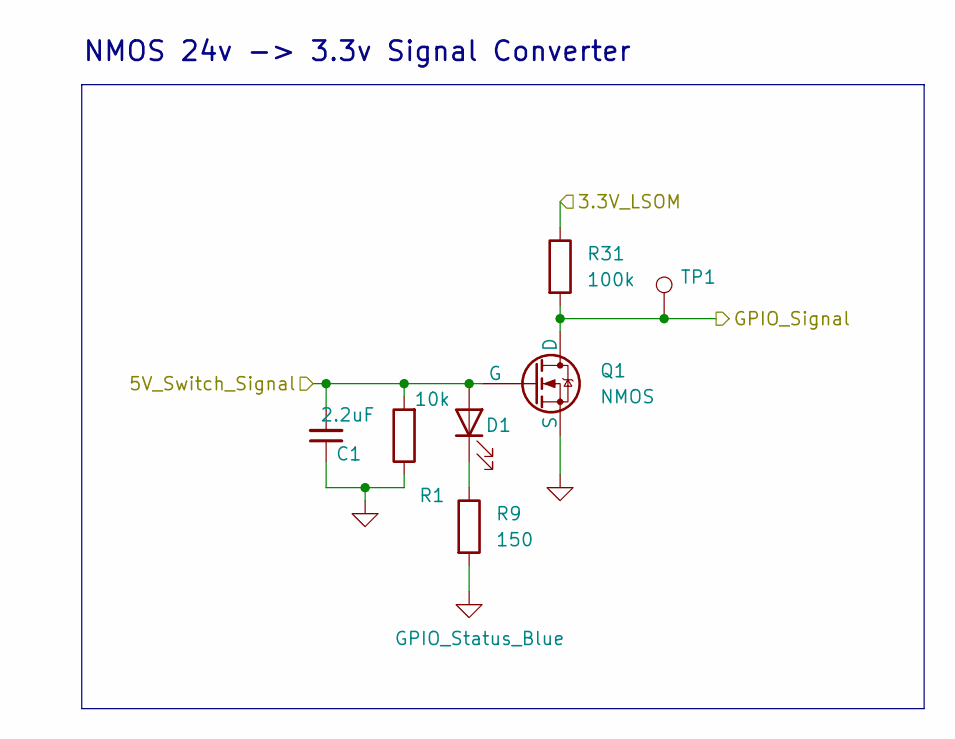
[picture p27: schematic NMOS_SW.kicad_sch]

Parts:
C1: 2.2uF; C_0603_1608Metric_Pad1.08x0.95mm_HandSolder
D1: GPIO_Status_Blue; LED_0603_1608Metric_Pad1.05x0.95mm_HandSolder
Q1: NMOS; SOT23
R1: 10k; R_0603_1608Metric_Pad0.98x0.95mm_HandSolder
R9: 150; R_0603_1608Metric_Pad0.98x0.95mm_HandSolder
R31: 100k; R_0603_1608Metric_Pad0.98x0.95mm_HandSolder
TP1: TestPoint; TestPoint_Pad_1.0x1.0mm

Connections:
/3.3V_LSOM: R31.1; also elsewhere on the board
/Regen_Active_GPIO_IN: Q1.1 (D), R31.2, TP1.1; also elsewhere on the board
/Regen_Active_Signal: C1.2, D1.2 (A), Q1.2 (G), R1.2; also elsewhere on the board
GND: C1.1, Q1.3 (S), R1.1, R9.2; also elsewhere on the board
unnamed: D1.1 (K), R9.1

Parts of its further copies:
C2, C3, C4, C5, C6, C7, C8, C9, C10, C11, C12, C13, C14, C28: 2.2uF; C_0603_1608Metric_Pad1.08x0.95mm_HandSolder
D2, D3, D5, D6, D7, D8, D9, D10, D11, D12, D13, D14, D15, D17: GPIO_Status_Blue; LED_0603_1608Metric_Pad1.05x0.95mm_HandSolder
Q3, Q4, Q5, Q7, Q8, Q9, Q10, Q11, Q12, Q13, Q14, Q15, Q16, Q18: NMOS; SOT23
R2, R3, R4, R5, R6, R7, R8, R12, R13, R14, R15, R16, R17, R45: 10k; R_0603_1608Metric_Pad0.98x0.95mm_HandSolder
R18, R19, R20, R21, R22, R23, R24, R25, R26, R27, R28, R29, R30, R46: 150; R_0603_1608Metric_Pad0.98x0.95mm_HandSolder
R32, R34, R35, R36, R37, R38, R39, R40, R41, R42, R43, R44, R57, R67: 100k; R_0603_1608Metric_Pad0.98x0.95mm_HandSolder
TP2, TP3, TP4, TP5, TP6, TP7, TP8, TP9, TP10, TP11, TP12, TP13, TP14, TP15: TestPoint; TestPoint_Pad_1.0x1.0mm

Connections of its further copies:
/3.3V_LSOM: R32.1, R34.1, R35.1, R36.1, R37.1, R38.1, R39.1, R40.1, R41.1, R42.1, R43.1, R44.1, R57.1, R67.1; also elsewhere on the board
/Cruise_Enable_GPIO_IN: Q10.1 (D), R39.2, TP8.1; also elsewhere on the board
/Cruise_Enable_Signal: C8.2, D9.2 (A), Q10.2 (G), R8.2; also elsewhere on the board
/Cruise_Set_GPIO_IN: Q11.1 (D), R40.2, TP9.1; also elsewhere on the board
/Cruise_Set_Signal: C9.2, D10.2 (A), Q11.2 (G), R12.2; also elsewhere on the board
/Fwd_SW_GPIO: Q3.1 (D), R32.2, TP2.1; also elsewhere on the board
/Fwd_SW_Signal: C2.2, D2.2 (A), Q3.2 (G), R2.2; also elsewhere on the board
/Hazard_GPIO_IN: Q13.1 (D), R42.2, TP11.1; also elsewhere on the board
/Hazard_Signal: C11.2, D12.2 (A), Q13.2 (G), R14.2; also elsewhere on the board
/Horn_5V_Signal: C12.2, D13.2 (A), Q14.2 (G), R15.2; also elsewhere on the board
/Horn_GPIO_IN: Q14.1 (D), R43.2, TP12.1; also elsewhere on the board
/Ign_OFF_GPIO: Q7.1 (D), R36.2, TP5.1; also elsewhere on the board
/Ign_arr_GPIO: Q8.1 (D), R37.2, TP6.1; also elsewhere on the board
/Ign_arr_Signal: C6.2, D7.2 (A), Q8.2 (G), R6.2; also elsewhere on the board
/Ign_mtr_GPIO: Q9.1 (D), R38.2, TP7.1; also elsewhere on the board
/Ign_mtr_Signal: C7.2, D8.2 (A), Q9.2 (G), R7.2; also elsewhere on the board
/Ign_off_Signal: C5.2, D6.2 (A), Q7.2 (G), R5.2; also elsewhere on the board
/Left_Blinker_ON: Q16.1 (D), R57.2, TP15.1; also elsewhere on the board
/Left_Blinker_Signal: C14.2, D15.2 (A), Q16.2 (G), R17.2; also elsewhere on the board
/Neutral_Gear_GPIO: Q4.1 (D), R34.2, TP3.1; also elsewhere on the board
/Neutral_Gear_Signal: C3.2, D3.2 (A), Q4.2 (G), R3.2; also elsewhere on the board
/PTT_GPIO_IN: Q18.1 (D), R67.2, TP14.1; also elsewhere on the board
/PTT_Signal: C28.2, D17.2 (A), Q18.2 (G), R45.2; also elsewhere on the board
/Regen_Enable_GPIO_IN: Q12.1 (D), R41.2, TP10.1; also elsewhere on the board
/Regen_Enable_Signal: C10.2, D11.2 (A), Q12.2 (G), R13.2; also elsewhere on the board
/Rev_SW_GPIO: Q5.1 (D), R35.2, TP4.1; also elsewhere on the board
/Rev_SW_Signal: C4.2, D5.2 (A), Q5.2 (G), R4.2; also elsewhere on the board
/Right_Blinker_ON: Q15.1 (D), R44.2, TP13.1; also elsewhere on the board
/Right_Blinker_Signal: C13.2, D14.2 (A), Q15.2 (G), R16.2; also elsewhere on the board
GND: C2.1, C3.1, C4.1, C5.1, C6.1, C7.1, C8.1, C9.1, C10.1, C11.1, C12.1, C13.1, C14.1, C28.1, Q3.3 (S), Q4.3 (S), Q5.3 (S), Q7.3 (S), Q8.3 (S), Q9.3 (S), Q10.3 (S), Q11.3 (S), Q12.3 (S), Q13.3 (S), Q14.3 (S), Q15.3 (S), Q16.3 (S), Q18.3 (S), R2.1, R3.1, R4.1, R5.1, R6.1, R7.1, R8.1, R12.1, R13.1, R14.1, R15.1, R16.1, R17.1, R18.2, R19.2, R20.2, R21.2, R22.2, R23.2, R24.2, R25.2, R26.2, R27.2, R28.2, R29.2, R30.2, R45.1, R46.2; also elsewhere on the board
unnamed: D2.1 (K), R18.1
unnamed: D3.1 (K), R19.1
unnamed: D5.1 (K), R20.1
unnamed: D6.1 (K), R21.1
unnamed: D7.1 (K), R22.1
unnamed: D8.1 (K), R23.1
unnamed: D9.1 (K), R24.1
unnamed: D10.1 (K), R25.1
unnamed: D11.1 (K), R26.1
unnamed: D12.1 (K), R27.1
unnamed: D13.1 (K), R28.1
unnamed: D14.1 (K), R29.1
unnamed: D15.1 (K), R30.1
unnamed: D17.1 (K), R46.1

Notes on the sheet:
NMOS 24v -> 3.3v Signal Converter

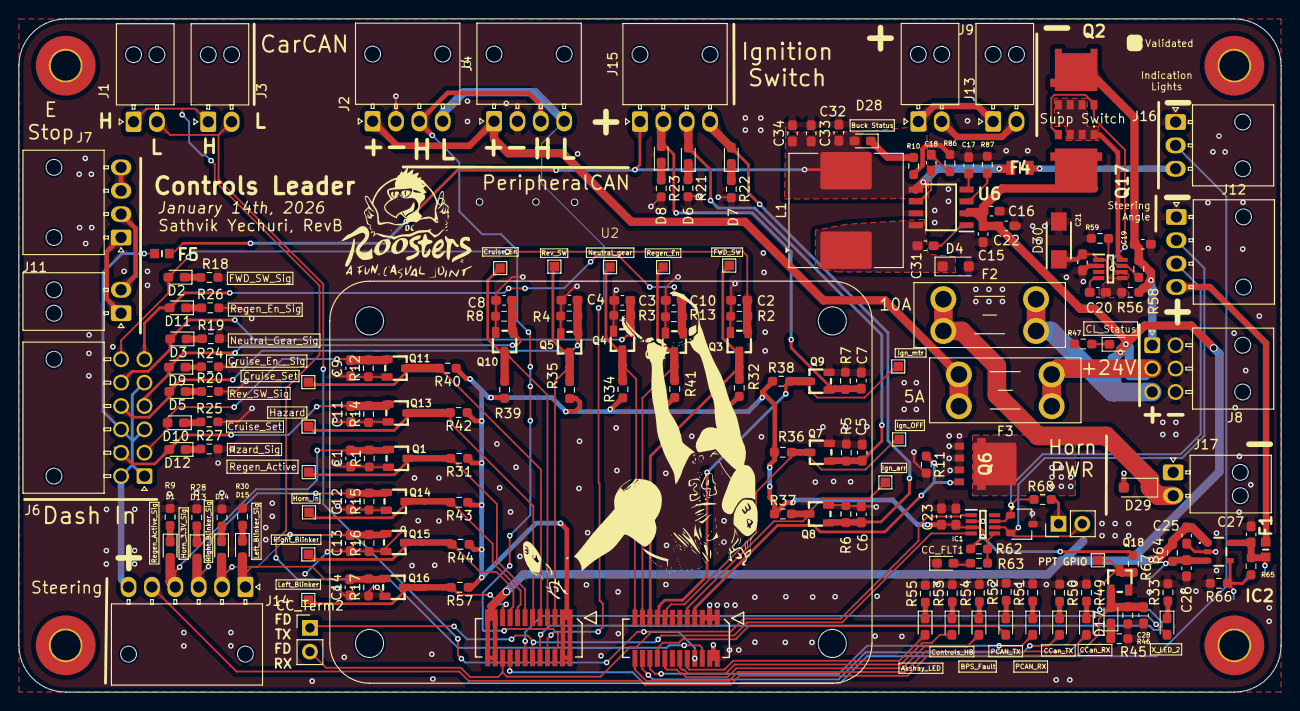
[picture p28: board ControlsLeader_PCB.kicad_pcb from above]

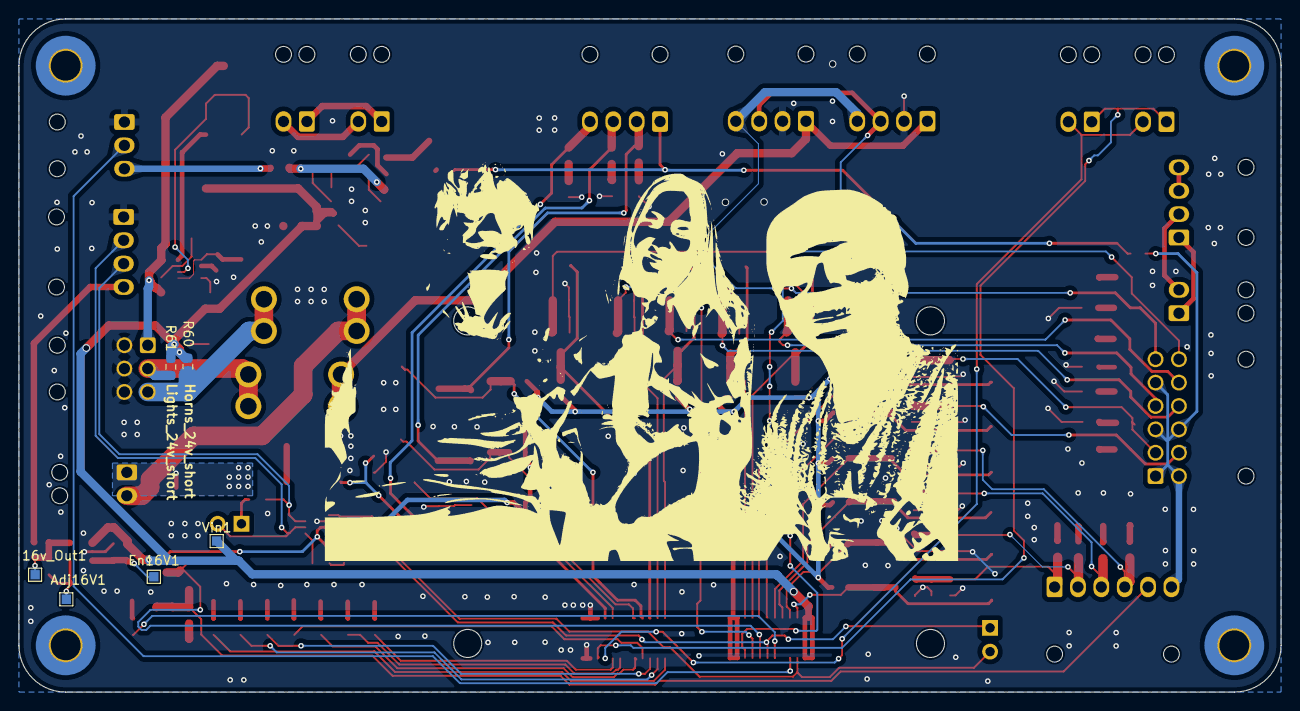
[picture p29: board ControlsLeader_PCB.kicad_pcb from below]

Board: 2 copper layers, 135.0 x 72.0 mm, 200 parts (6 on the bottom side), 108 nets.

Other parts of the board:
C15, C32, C33, C34: 10uF; C_0603_1608Metric_Pad1.08x0.95mm_HandSolder
C16: 1uF; C_0603_1608Metric_Pad1.08x0.95mm_HandSolder
C17: 10nF; C_0603_1608Metric_Pad1.08x0.95mm_HandSolder
C18: 3.3nF; C_0603_1608Metric_Pad1.08x0.95mm_HandSolder
C31: 0.1uF; C_0603_1608Metric_Pad1.08x0.95mm_HandSolder
D4: MBR230S1F; D_SOD-123F
L1: 100uH; L_Coilcraft_MSS1246-XXX
R86: 16k; R_0603_1608Metric_Pad0.98x0.95mm_HandSolder
R87: ROSC; R_0603_1608Metric_Pad0.98x0.95mm_HandSolder
U6: TPS5405DR

Their connections:
+24V: C15.1, C16.1, U6.2 (VIN); also elsewhere on the board
/5V_Buck: C32.1, C33.1, C34.1, L1.2, U6.5 (VSENSE); also elsewhere on the board
/24v_5v_Buck/LX: C31.2, D4.1 (K), L1.1, U6.8 (LX)
/24v_5v_Buck/ROSC: R87.1, U6.3 (ROSC)
GND: C15.2, C16.2, C17.2, C32.2, C33.2, C34.2, D4.2 (A), R86.2, R87.2, U6.7 (GND); also elsewhere on the board
unnamed: C18.2, R86.1
unnamed: C31.1, U6.1 (BOOT)
unnamed: C18.1, U6.6 (COMP)
unnamed: C17.1, U6.4 (SS)
