lhr-solar/Controls-DashboardPCB/Dashboard PCB.kicad_pcb

## KiCad design Dashboard PCB.kicad_pcb (2025-03-05)

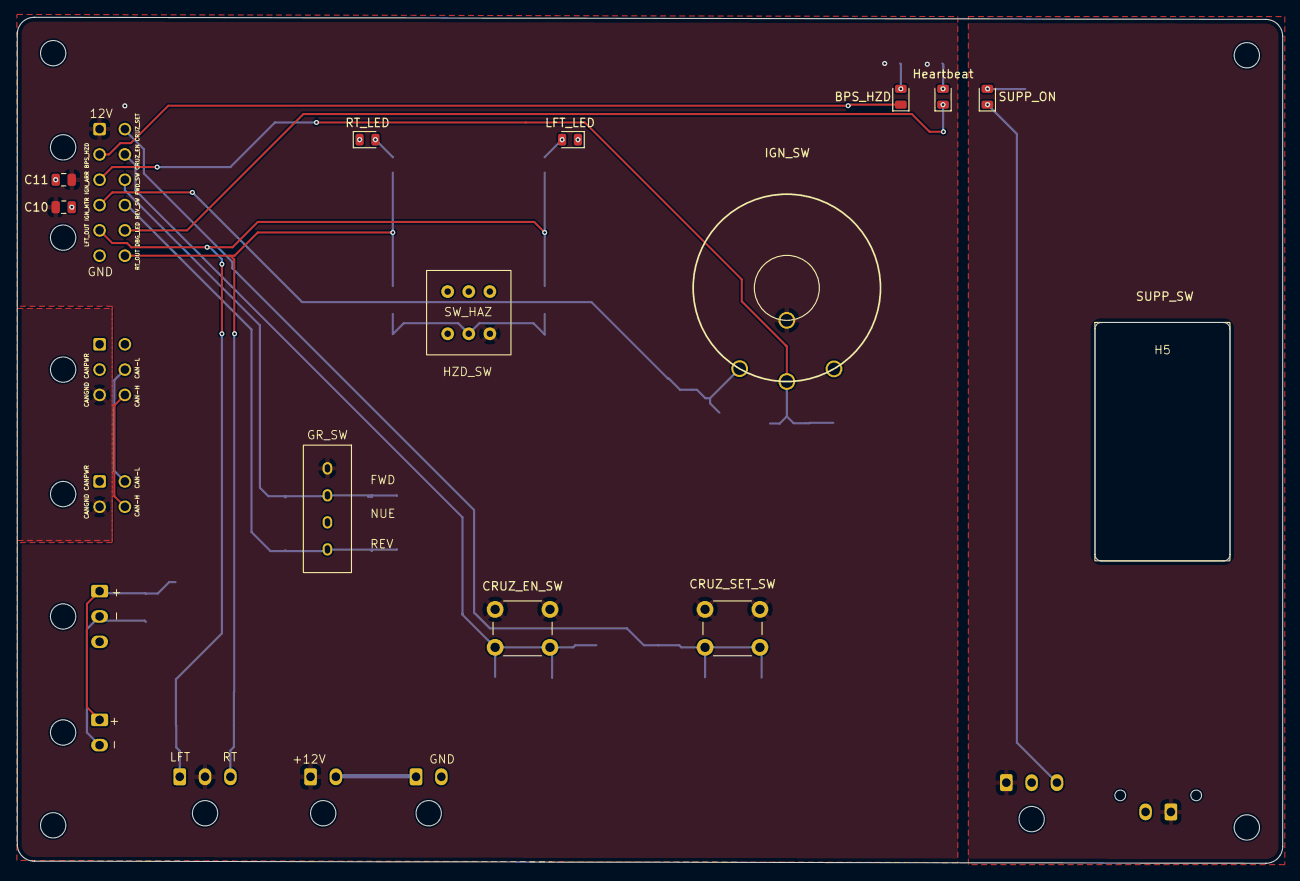
[picture p30: board Dashboard PCB.kicad_pcb from above]

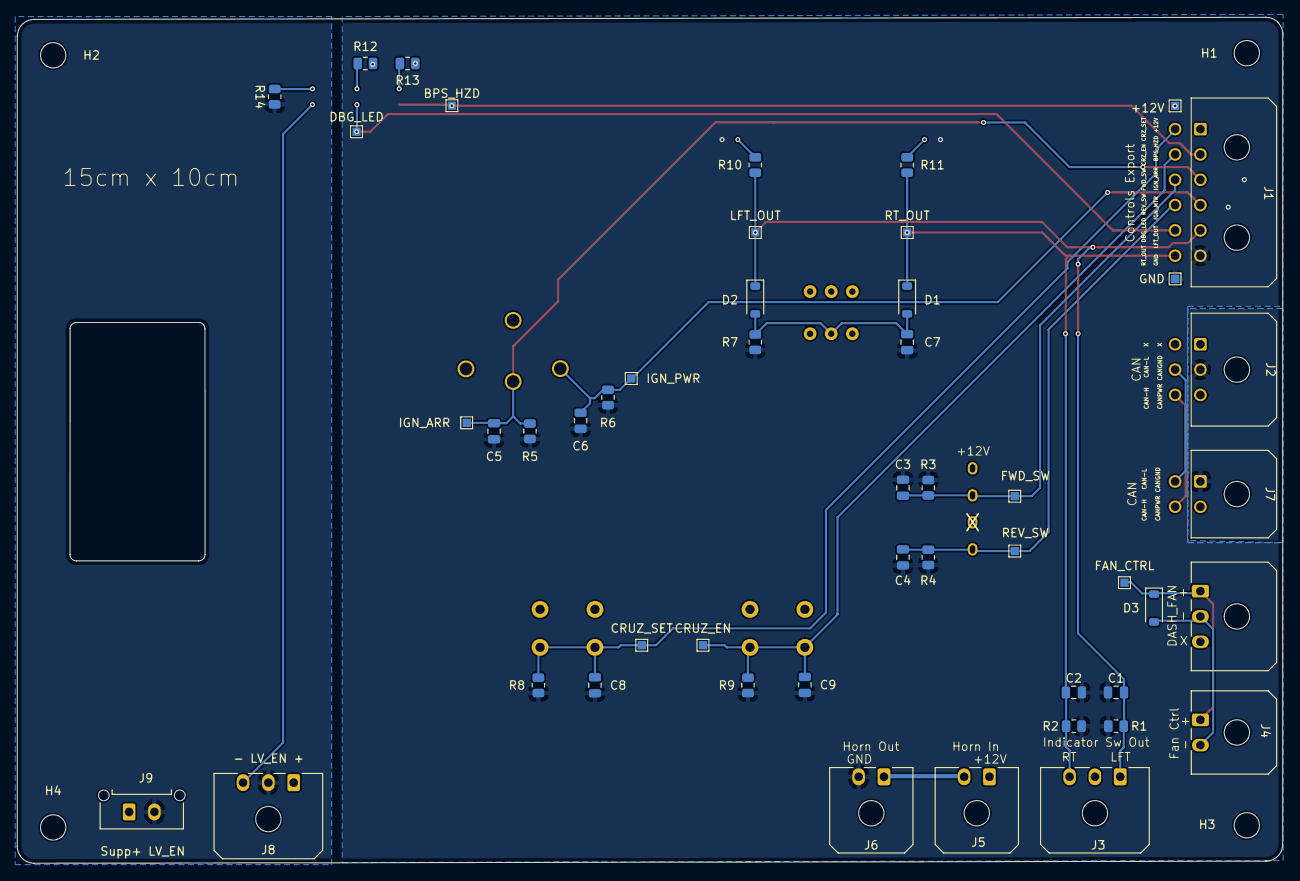
[picture p31: board Dashboard PCB.kicad_pcb from below]

Board: 2 copper layers, 150.0 x 100.2 mm, 66 parts (49 on the bottom side), 28 nets.

Parts:
+12V: TestPoint; TestPoint_Pad_1.0x1.0mm
BPS_HZD: SMD_0805_RED; LED_0805_2012Metric
BPS_HZD#2: TestPoint; TestPoint_Pad_1.0x1.0mm
C1, C2, C3, C4, C5, C6, C7, C8, C9: 5uF; C_0805_2012Metric
C10, C11: 100uF; C_0805_2012Metric
CRUZ_EN: TestPoint; TestPoint_Pad_1.0x1.0mm
CRUZ_EN_SW: CRUSE_EN_SW_12V; SW_PUSH_6mm
CRUZ_SET: TestPoint; TestPoint_Pad_1.0x1.0mm
CRUZ_SET_SW: CRUSE_SET_SW_12V; SW_PUSH_6mm
D1, D2: BAV16W; D_SOD-123
D3: 1N5819HW; D_SOD-123
DASH_FAN1: DASHBOARD_FAN_12V; Molex_Micro-Fit_3.0_43650-0300_1x03_P3.00mm_Horizontal
DBG_LED: TestPoint; TestPoint_Pad_1.0x1.0mm
FAN_CTRL: TestPoint; TestPoint_Pad_1.0x1.0mm
FWD_SW: TestPoint; TestPoint_Pad_1.0x1.0mm
GND: TestPoint; TestPoint_Pad_1.0x1.0mm
GR_SW: GEAR_SW_12V; 3posSlideToggle
H1, H2, H3, H4: MountingHole; MountingHole_3mm
H5: SuppSwitchMount; Supp_Switch
HZD_SW: HAZARD_SWITCH_12V; Toggle
Heartbeat: SMD_0805_GRN; LED_0805_2012Metric
IGN_ARR: TestPoint; TestPoint_Pad_1.0x1.0mm
IGN_PWR: TestPoint; TestPoint_Pad_1.0x1.0mm
IGN_SW1: IGNITION_SW_12V; SW_3POS_ROT
J1: Controls_Leader_Export_02x06; Molex_Micro-Fit_3.0_43045-1200_2x06_P3.00mm_Horizontal
J2: Conn_02x03_CAN; Molex_Micro-Fit_3.0_43045-0600_2x03_P3.00mm_Horizontal
J3: INDICATOR_SWITCH_OUT; Molex_Micro-Fit_3.0_43650-0300_1x03_P3.00mm_Horizontal
J4: FAN_CTRL_01x02; Molex_Micro-Fit_3.0_43650-0200_1x02_P3.00mm_Horizontal
J5: Horn_In_01x02; Molex_Micro-Fit_3.0_43650-0200_1x02_P3.00mm_Horizontal
J6: Horn_Out_01x02; Molex_Micro-Fit_3.0_43650-0200_1x02_P3.00mm_Horizontal
J7: Conn_02x03_CAN; Molex_Micro-Fit_3.0_43045-0400_2x02_P3.00mm_Horizontal
J8: Supp_Out; Molex_Micro-Fit_3.0_43650-0300_1x03_P3.00mm_Horizontal
J9: Supp_In; Molex_Micro-Fit_3.0_43650-0215_1x02_P3.00mm_Vertical
LFT_LED: SMD_0805; LED_0805_2012Metric
LFT_OUT: TestPoint; TestPoint_Pad_1.0x1.0mm
R1, R2, R3, R4, R5, R6, R7, R8, R9: 10k; R_0805_2012Metric
R10, R11, R12, R14: 5.1k; R_0805_2012Metric
R13: HZD_RES_VAL; R_0805_2012Metric
REV_SW: TestPoint; TestPoint_Pad_1.0x1.0mm
RT_LED: SMD_0805; LED_0805_2012Metric
RT_OUT: TestPoint; TestPoint_Pad_1.0x1.0mm
SUPP_ON: LED; LED_0805_2012Metric

Connections:
+12V: +12V.1, C10.1, C11.1, CRUZ_EN_SW.1, CRUZ_SET_SW.1, GR_SW.1, HZD_SW.1, IGN_SW1.1, J1.1, J3.2, J5.1, R12.1, R13.1
/BPS_HZD: BPS_HZD.1 (K), BPS_HZD#2.1, J1.2
/CAN+12V: J2.3, J7.2
/CAN-H: J2.6, J7.4
/CAN-L: J2.5, J7.3
/CANGND: J2.2, J7.1
/CRUZ_EN: C9.1, CRUZ_EN.1, CRUZ_EN_SW.2, J1.8, R9.2
/CRUZ_SET: C8.1, CRUZ_SET.1, CRUZ_SET_SW.2, J1.7, R8.1
/DBG_LED: DBG_LED.1, Heartbeat.1 (K), J1.11
/FAN+: D3.1 (K), DASH_FAN1.1, FAN_CTRL.1, J4.1
/FAN-: D3.2 (A), DASH_FAN1.2, J4.2
/FWD_SW: C3.2, FWD_SW.1, GR_SW.2, J1.9, R3.2
/IGN_ARR: C5.1, IGN_ARR.1, IGN_SW1.3, J1.3, R5.2
/IGN_MTR: C6.1, IGN_PWR.1, IGN_SW1.2, J1.4, R6.2
/LFT_OUT: C1.2, D2.1 (K), J1.5, J3.1, LFT_OUT.1, R1.1, R10.1
/LV_EN: J8.2, J9.2, R14.1
/REV_SW: C4.1, GR_SW.4, J1.10, R4.1, REV_SW.1
/RT_OUT: C2.1, D1.1 (K), J1.12, J3.3, R2.2, R11.1, RT_OUT.1
/Supp+: J8.1, J9.1
/Supp-: J8.3, SUPP_ON.1 (K)
GND: C1.1, C2.2, C3.1, C4.2, C5.2, C6.2, C7.2, C8.2, C9.2, C10.2, C11.2, GND.1, J1.6, J6.2, LFT_LED.1 (K), R1.2, R2.1, R3.1, R4.2, R5.1, R6.1, R7.1, R8.2, R9.1, RT_LED.1 (K)
unnamed: BPS_HZD.2 (A), R13.2
unnamed: C7.1, D1.2 (A), D2.2 (A), HZD_SW.2, R7.2
unnamed: R14.2, SUPP_ON.2 (A)
unnamed: Heartbeat.2 (A), R12.2
unnamed: J5.2, J6.1
unnamed: LFT_LED.2 (A), R10.2
unnamed: R11.2, RT_LED.2 (A)
