lhr-solar/Controls-DashboardPCB/firmware/core/Src/Debugging.c

#include "Debugging.h"

void HAL_UART_MspGPIOInit(UART_HandleTypeDef *huart) {

    GPIO_InitTypeDef init = {0};
    __HAL_RCC_GPIOC_CLK_ENABLE();
    /**USART3 GPIO Configuration
    PC10     ------> USART3_TX
    PC11     ------> USART3_RX
    */
    init.Pin = GPIO_PIN_10|GPIO_PIN_11;
    init.Mode = GPIO_MODE_AF_PP;
    init.Pull = GPIO_NOPULL;
    init.Speed = GPIO_SPEED_FREQ_LOW;
    init.Alternate = GPIO_AF7_USART3;
    HAL_GPIO_Init(GPIOC, &init);

}

void initPrintf(){
    
    husart3->Init.BaudRate = 115200;
    husart3->Init.WordLength = UART_WORDLENGTH_8B;
    husart3->Init.StopBits = UART_STOPBITS_1;
    husart3->Init.Parity = UART_PARITY_NONE;
    husart3->Init.Mode = UART_MODE_TX_RX;
    husart3->Init.HwFlowCtl = UART_HWCONTROL_NONE;
    husart3->Init.OverSampling = UART_OVERSAMPLING_16;

    printf_init(husart3);
}
