lhr-solar/Controls-DashboardPCB/firmware/drivers/Src/Horn.c

#include "init.h"
#include "Horn.h"
#include "Switches.h"

void horn_gpio_init() {
    gpioPin_Init(HORN_OUT_PORT, HORN_OUT_PIN, GPIO_MODE_OUTPUT_PP);
	horn_set(SWITCH_OFF);
}

void horn_set(switch_state_t state) {
    HAL_GPIO_WritePin(HORN_OUT_PORT, HORN_OUT_PIN, state);
}
