lhr-solar/Controls-DashboardPCB/firmware/drivers/Src/Status_LEDs.c

#include "init.h"
#include "Status_LEDs.h"

static bool bps_strobe = false;

void led_gpio_init() {
    gpioPin_Init(PH_CAN_RX_LED_PORT,  PH_CAN_RX_LED_PIN,  GPIO_MODE_OUTPUT_PP);
    gpioPin_Init(CAR_CAN_RX_LED_PORT, CAR_CAN_RX_LED_PIN, GPIO_MODE_OUTPUT_PP);
    gpioPin_Init(CAR_CAN_TX_LED_PORT, CAR_CAN_TX_LED_PIN, GPIO_MODE_OUTPUT_PP);
    gpioPin_Init(PH_CAN_TX_LED_PORT,  PH_CAN_TX_LED_PIN,  GPIO_MODE_OUTPUT_PP);
    gpioPin_Init(X_LED2_PORT,         X_LED2_PIN,         GPIO_MODE_OUTPUT_PP);
    gpioPin_Init(CONTROLS_HB_LED_PORT,CONTROLS_HB_LED_PIN,GPIO_MODE_OUTPUT_PP);
    gpioPin_Init(AKSHAY_LED_PORT,     AKSHAY_LED_PIN,     GPIO_MODE_OUTPUT_PP);
    gpioPin_Init(BPS_FAULT_LED_PORT,  BPS_FAULT_LED_PIN,  GPIO_MODE_OUTPUT_PP);
    gpioPin_Init(LSOM_HB_PORT,        LSOM_HB_PIN,        GPIO_MODE_OUTPUT_PP);
}

void led_set(GPIO_TypeDef *port, uint16_t pin, GPIO_PinState state) {
	if(port == NULL) return;
    HAL_GPIO_WritePin(port, pin, state);
}

void led_toggle(GPIO_TypeDef *port, uint16_t pin) {
	if(port == NULL) return;
    HAL_GPIO_TogglePin(port, pin);
}

void flash_them() {
    led_toggle(PH_CAN_RX_LED_PORT,  PH_CAN_RX_LED_PIN);
    led_toggle(BPS_FAULT_LED_PORT,   BPS_FAULT_LED_PIN);
    led_toggle(CAR_CAN_RX_LED_PORT,  CAR_CAN_RX_LED_PIN);
    led_toggle(CAR_CAN_TX_LED_PORT,  CAR_CAN_TX_LED_PIN);
    led_toggle(PH_CAN_TX_LED_PORT,   PH_CAN_TX_LED_PIN);
    led_toggle(X_LED2_PORT,          X_LED2_PIN);
    led_toggle(CONTROLS_HB_LED_PORT, CONTROLS_HB_LED_PIN);
    led_toggle(LSOM_HB_PORT,         LSOM_HB_PIN);
    led_toggle(AKSHAY_LED_PORT,      AKSHAY_LED_PIN);
}


void updateBPS_strobe(uint8_t bps_fault) {
	if(bps_fault == 0) bps_strobe = false;
	else bps_strobe = true;
		/**
		 * 
		 * @todo 	maybe do more stuff here
		 * 
		 */
}
