lhr-solar/Controls-DashboardPCB/(commit log)

2025-03-05 Dashboard PCB :anguished: (#1)
    * Dashboard PCB :anguished:
    * Ready for review I think :+1:
    Switched design from modular to big board :). Plz rev schem thaks :P
    * Hotfix
    Changed ignition switch to not have ON, and added supp pwr switch
    * Added dashboard fan connection
    Not sure if i need to do anything specific with the fan (flyback diode?)
    * Updated dashboard
    Took off some unnecessary connections
    * Major redisign
    Added a lot of stuff and redesigned a lot of stuff
    * ddelet img
    * Update 1/2
    Fixed some of the requested changes.
    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
    [1x2vert.stp, 1x3.stp, 2pin.stp, 2x2.stp, 2x3.stp, 2x6.stp, Dashboard PCB.kicad_pcb, Dashboard PCB.kicad_sch]
2025-12-27 ShaqDash is born. . . RPP in progress
    [ControlsLeader_PCB.kicad_pcb, ControlsLeader_PCB.kicad_sch, NMOS_SW.kicad_sch, RPP.kicad_sch, Status_LEDs.kicad_sch, Steering_Wheel.kicad_sch, dash.kicad_sch]
2025-12-28 Rev B :)
    [ControlsLeader_PCB.kicad_pcb, RPP.kicad_sch]
2026-01-14 Steering Angle Sensor SCH changes
    [AP2205-50W5-7.STEP, CanTransciever.kicad_sch, ControlsLeader_PCB.kicad_pcb, ControlsLeader_PCB.kicad_sch, RPP.kicad_sch, SteerinAngle.kicad_sch, steeringAngleLDO.kicad_sch]
2026-01-15 revb layout, working on silkscreen
    [CanTransciever.kicad_sch, ControlsLeader_PCB.kicad_pcb, ControlsLeader_PCB.kicad_sch, NMOS_SW.kicad_sch, RPP.kicad_sch, Status_LEDs.kicad_sch, SteerinAngle.kicad_sch, Steering_Wheel.kicad_sch]
2026-01-15 RevB done :)
    [0603L025YR.stp, 1x06_horizontal.stp, 1x3_horizontal.stp, 2x6_horizontal.stp, ControlsLeader_PCB.kicad_pcb, IRLML2030TRPBF.stp]
2026-01-15 Rev B Gerbers and JLCpcb stuff :)
    [ControlsLeader_PCB-B_Cu.gbr, ControlsLeader_PCB-B_Mask.gbr, ControlsLeader_PCB-B_Paste.gbr, ControlsLeader_PCB-B_Silkscreen.gbr, ControlsLeader_PCB-Edge_Cuts.gbr, ControlsLeader_PCB-F_Cu.gbr, ControlsLeader_PCB-F_Mask.gbr, ControlsLeader_PCB-F_Paste.gbr]
2026-01-15 Final fixes
    [0805L100WR.stp, AP2205-50W5-7.STEP, CanTransciever.kicad_sch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]
2026-01-15 gerber and jlc files
    [ControlsLeader_PCB-B_Cu.gbr, ControlsLeader_PCB-B_Mask.gbr, ControlsLeader_PCB-B_Paste.gbr, ControlsLeader_PCB-B_Silkscreen.gbr, ControlsLeader_PCB-Edge_Cuts.gbr, ControlsLeader_PCB-F_Cu.gbr, ControlsLeader_PCB-F_Mask.gbr, ControlsLeader_PCB-F_Paste.gbr]
2026-01-15 updated jlc parts list
    [ControlsLeader_PCB-CuBottom.gbr, ControlsLeader_PCB-CuTop.gbr, ControlsLeader_PCB-EdgeCuts.gbr, ControlsLeader_PCB-MaskBottom.gbr, ControlsLeader_PCB-MaskTop.gbr, ControlsLeader_PCB-NPTH.drl, ControlsLeader_PCB-PTH.drl, ControlsLeader_PCB-SilkBottom.gbr]
2026-01-16 cleaning up files
    [2x6.stp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]
2026-01-23 Mika is quite smart (#12)
    [0603L025YR.stp, 0805L100WR.stp, 1x06_horizontal.stp, 1x3_horizontal.stp, 2x6.stp, 2x6_horizontal.stp, AP2205-50W5-7.STEP, CanTransciever.kicad_sch]
2026-04-01 Rev b (#8)
    * Branch Init
    * Schematic done, GPIO on .ioc TBD
    * Board review
    * Fixing kicad sharepoint
    * Reinit KiCAD Sharepoint
    * Schematic Backup
    * DONE!!! - just need to add footprints + part #s)
    * now DONE!!! - still needs footprints
    * Schematic Ready for Review - Just need FET footprints to be confirmed
    * LDO Subpage renamed - still need FET footprints
    * Ready for final review
    * Removed Extra LED 6
    * Updated LSOM status LED and horn 24v signal connector layout
    * All footprints added
    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
2026-04-05 Dash Drivers (#14)
    * firmware init 2.0
    * IO testing
    * Delete firmware/.venv directory
    * IO test 1.1
    * IO TEST WORKSSS
    * ew build, only mika would keep ts
    * .h files done
    * TODO: software design ip
    * github actions and flash-uart code
    * RTOS Structure done, need to write actuaul functions (currently have blinky which tweaks)
    * gpio interruptss in progress
    * meh
    * PLEASEEEE CHUDSHAYYY
    * breh
    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
2026-08-02 Highnoon Production Code
    * remove orphaned submodule hardware/ControlsLeader_PCB/lib/KiCAD-Sharepoint
    * re adding embedded share p
    * aarav chud
    * mehhhhhhhhhhhhhhhhhhhhhhhhhhhhhhhhhhhhhhhhhhhhhhhhhhh
    * i'm stupid
    * bahhhh
    * im dum
    * BROOOOOOOOOOOOOOOOOOOOOOOOOOO
    * im very very dum
    * hmmmmmmmmm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
