lhr-solar/Controls-DashboardPCB/(notices)

Notices in the files:
3d models/rotary.stp:
author */ ('License CC BY-ND 4.0'),
